TylerMiddendorf/bullet-time-cam/docs/evidence/README.md

# Evidence Index

Evidence is grouped by the milestone and checkpoint whose exit gate it supports.
Raw logs, screenshots, manifests, and summaries stay together so a result can be
reviewed without searching one large flat directory.

## Milestone 1 — Bench-Top End-to-End Capture

- [`checkpoint-1/`](milestone-1/checkpoint-1/) — Raspberry Pi, display, USB, and bench inventory
- [`checkpoint-4/`](milestone-1/checkpoint-4/) — one-node trigger-to-screen vertical slice, protocol fault/recovery tests, firmware deployment, electrical inspection, and four-node trigger integrity
- [`checkpoint-5/`](milestone-1/checkpoint-5/) — completed four-node product grouping, GIF/touchscreen flow, 25-cycle reliability, per-camera partial failures, corrupt/truncated recovery, reboot identity, byte validator, and UI photographs

## Milestone 2 — User-Removable USB Media

- [`removable-media-qualification-2026-07-18.md`](milestone-2/removable-media-qualification-2026-07-18.md)
  — complete real-Pi hardware matrix covering normal/reboot/reinsert/remount,
  missing/full/read-only/corrupt/mid-write loss, recovery, deterministic
  two-drive selection, and the physical-rig E2E test; it records the initial
  media-safety pass and the UI/filesystem findings discovered during that run
- [`focused-retest-and-fat-repair-2026-07-18.md`](milestone-2/focused-retest-and-fat-repair-2026-07-18.md)
  — app 0.2.1 fixes, automated tests, file-for-file product backup, FAT repair,
  stale-staging cleanup, focused real-UI removal/error retest, clean post-capture
  FAT check, and final byte-valid capture closing Milestone 2

- [`../MILESTONE_2_PLAN.md`](../MILESTONE_2_PLAN.md) — completed fault procedures,
  safety boundaries, evidence requirements, and exit gates
- [`milestone-2/`](milestone-2/) — USB-media discovery, mount bring-up, and
  qualifying fault/recovery evidence

## Qt Touchscreen Platform Track

- [`qt-ui-deployment-2026-07-18.md`](qt-touchscreen/qt-ui-deployment-2026-07-18.md)
  - tracked deployment chain, power-cycle recovery, native-Wayland validation,
  bounded real capture, product-media library performance, and final hardware
  state
- [`2026-07-18-pi-routes/`](qt-touchscreen/2026-07-18-pi-routes/) - seven final
  800x480 Pi route screenshots and their SHA-256 evidence manifest
- [`library-deletion-2026-07-19.md`](qt-touchscreen/library-deletion-2026-07-19.md)
  - confirmed whole-set deletion, native renders, and a disposable real-USB
  operation that preserved every pre-existing capture directory
- [`storage-capacity-2026-07-19.md`](qt-touchscreen/storage-capacity-2026-07-19.md)
  - app 0.2.4 used/available USB capacity metric, post-deployment asynchronous
  refresh regression and fix, exact real-capture/volume check, corrected native
  800x480 render, and final Pi runtime state
- [`navigation-reorganization-2026-07-19.md`](qt-touchscreen/navigation-reorganization-2026-07-19.md)
  - app 0.2.5 Ready/Settings/Library/Capture navigation, Capture-only
  touchscreen command boundary, commit/push/Pi-pull chain, final Pi tests,
  native-Wayland renders, actual live status screen, and the disconnected-node
  limitation
- [`navigation-icon-sizing-2026-07-19.md`](qt-touchscreen/navigation-icon-sizing-2026-07-19.md)
  - app 0.2.6 large Ready gear and Library home icon, native Pi render and
  interaction checks, commit/push/Pi-pull chain, and restarted-service health

## Milestone 5 — Fast Follow

- [`live-preview-2026-07-19.md`](milestone-5/live-preview-2026-07-19.md) —
  firmware/app 0.3.0, four-node memory-only preview, native 800x480 runtime,
  preview-active capture and comparison timing, USB recovery, post-recovery
  preview/capture, screenshots, manifests, and final boot/service state

Each new evidence directory should include or link to the relevant plan, state
the date and tested revision, distinguish successful gates from limitations,
and retain concrete artifacts where practical.
