TylerMiddendorf/bullet-time-cam/assets/ui/README.md

# Touchscreen UI Assets

`preview-placeholder.png` is generated test media for the Qt touchscreen
implementation. It provides a stable background for layout, focus-overlay, and
touch testing without implementing or implying a live camera stream.

The placeholder was generated on July 18, 2026 with the built-in image
generation tool using `assets/Logo_800x480.png` as its visual reference. Prompt
summary: a dark, wide camera-viewfinder background preserving the logo's black,
white, silver, and blue identity, with restrained optical rings and four-camera
geometry. It contains no embedded UI, text, watermark, battery indicator, or
claim that a live stream exists.

The runtime may scale or crop this image to the 800x480 display. Replace it only
when real preview transport becomes an explicitly approved milestone.
