TylerMiddendorf/bullet-time-cam/docs/CURRENT_SESSION.md

# Current Session - Fast-Follow Software

Status reviewed: July 19, 2026

## Qt UX Implementation Rollback Baseline

- Work on the Qt Quick/PySide6 interface began from Git commit `63420c1`
  (`Accept external V1 power arrangement`) on branch `main`.
- No files were staged when the implementation session began. An existing
  unstaged product-owner edit to `docs/MILESTONE_4_PLAN.md` was deliberately
  left untouched and is not part of the UI rollback baseline.
- To return to the exact pre-UI repository state without discarding unrelated
  working-tree changes, restore the UI commits relative to `63420c1`; do not
  use a destructive working-tree reset.
- Scope guard: implement the supplied UX mockups with a generated temporary
  preview image, but do not implement a live camera stream and do not display
  battery level or battery status.
- The completed Qt runtime is `fb1d1e7`. Pre-UI commit `63420c1`, the installer
  backup, and retained Tk packages provide a documented non-destructive recovery
  path, but an end-to-end rollback drill has not been performed.

## Verified State

- Milestones 1 and 2 are complete. The full four-camera workflow and removable
  USB fault/recovery behavior are physically validated.
- App 0.2.1 survives disappearance of its reviewed GIF, fits bounded errors on
  the 800x480 display, and cleans expired staging safely.
- The product FAT was backed up, repaired, and returned a clean offline check
  after final actual-UI capture `20260718T175104Z_04b69c0b`.
- The product owner accepted an external battery pack as the V1 power solution.
  It supplies separate rated 5 V / 2 A feeds to the Raspberry Pi and powered
  USB hub and has its own battery-percentage display.
- Aggregate measurement, internal battery/charging integration, and automatic
  safe-power sequencing are retired as V1 gates. No electrical measurement or
  coordinated shutdown evidence is claimed.
- The complete removable-media follow-up is in
  [`evidence/milestone-2/focused-retest-and-fat-repair-2026-07-18.md`](evidence/milestone-2/focused-retest-and-fat-repair-2026-07-18.md).
- Native Qt Quick/PySide6 now runs on the Pi's 800x480 Wayland session. Seven
  routes, a bounded real four-camera capture, and the 214-entry USB
  library passed SSH-accessible validation. Preview remains a labeled static
  logo fixture and the UI contains no battery state. Evidence is in
  [`evidence/qt-touchscreen/qt-ui-deployment-2026-07-18.md`](evidence/qt-touchscreen/qt-ui-deployment-2026-07-18.md).
- Confirmed deletion from the library and viewer is deployed at `3f99e76`.
  Pi tests, corrected native viewer/confirmation renders, and a disposable
  four-JPEG/GIF/manifest set on the real product USB passed while retaining all
  222 pre-existing capture directories. Evidence is in
  [`evidence/qt-touchscreen/library-deletion-2026-07-19.md`](evidence/qt-touchscreen/library-deletion-2026-07-19.md).
- The first Qt soft reboot failed to return to the LAN and required a physical
  power cycle. Recovery checks passed, but no persistent journal was available;
  the cause and clean Qt soft-reboot lifecycle remain open.
- App 0.2.5 reorganizes Ready into status plus gear/Settings, Library, and
  Capture navigation. Capture is the only touchscreen photo-taking route; its
  surface remains a truthfully labeled static placeholder pending live preview.
  Final commit `1d880c1` is deployed on the Pi and passed the final suite,
  native-Wayland renders, boot verifier, and live-screen inspection. The camera
  nodes were not enumerated, so no new physical capture was made in this pass.
- App 0.2.6 is deployed at `4be243c`. Ready's Settings gear and Library's home
  icon now fill most of their touch buttons. The final Pi suite, native route
  renders, Library-to-Ready interaction smoke, boot verifier, and restarted
  live service passed. Evidence is in
  [`evidence/qt-touchscreen/navigation-icon-sizing-2026-07-19.md`](evidence/qt-touchscreen/navigation-icon-sizing-2026-07-19.md).
- App 0.2.7 camera USB recovery is deployed at `83cfda4`. The Settings action
  passed native 800x480 rendering, the exact guarded root one-shot, four usable
  stable camera sessions, byte-valid capture `20260719T200154Z_65b3fe04`, the
  126-test Pi run with one expected skip, and all 39 boot checks. The product
  FAT was backed up, repaired, and verified clean offline; the retained backup
  is `/home/username/usb-recovery-backups/20260719T1605-camera-recovery`.
  Evidence is in
  [`evidence/qt-touchscreen/camera-usb-recovery-2026-07-19.md`](evidence/qt-touchscreen/camera-usb-recovery-2026-07-19.md).
- App 0.2.8 is deployed at `2153c7a`. Ready shows real removable-USB connected
  state, a circular used-capacity gauge, and available capacity; Settings has a
  large direct-to-Ready home icon matching Library. The 127-test Pi run with
  one expected skip, native renders, real product-volume read, interaction
  smoke, all 39 boot checks, and restarted live service passed. Evidence is in
  [`evidence/qt-touchscreen/ready-usb-storage-and-settings-home-2026-07-19.md`](evidence/qt-touchscreen/ready-usb-storage-and-settings-home-2026-07-19.md).
- App 0.2.9 is deployed at `ea9e4c5`. New usable captures atomically include a
  compact manifest-recorded JPEG library preview; catalog refresh reads it
  without opening the animation. Real four-camera capture
  `20260719T224502Z_b091c2b9` validated the preview and the live service was
  restored with all 39 boot/session checks passing. Evidence is in
  [`evidence/qt-touchscreen/library-capture-previews-2026-07-19.md`](evidence/qt-touchscreen/library-capture-previews-2026-07-19.md).
- App and firmware 0.3.0 are deployed through `ab8c357`. All four stable nodes
  serve bounded 320x240 memory-only previews; the native Capture route displays
  genuine rotating frames and stops preview before capture. Preview-active and
  comparison captures completed in 3.721 and 3.691 seconds respectively. The
  installed xHCI recovery, post-recovery preview and capture
  `20260720T005232Z_54ad4ce8`, 137 source tests, native 800x480 QML, all 39 boot
  checks, normal service, and GPIO17 LOW passed. Evidence is in
  [`evidence/milestone-5/live-preview-2026-07-19.md`](evidence/milestone-5/live-preview-2026-07-19.md).

## Immediate Work

Milestone 4 is deferred as active repository work while the product owner builds
the full enclosed prototype asynchronously. Its plan and acceptance gates remain
open and must be completed before the enclosure milestone is closed.

Continue with Milestone 5 software work:

1. Improve ordinary user-facing status and recovery behavior where demonstrated
   gaps exist.
2. Continue investigating the soft two-second latency target and unexplained Qt
   soft-reboot failure as bounded software reliability work.
