TylerMiddendorf/bullet-time-cam/docs/PROJECT_CONTEXT.md

# Bullet-Time Camera Rig - Project Context

This file is the durable project brief. Update it as product decisions are made so future work can begin from the actual system goal rather than treating the ESP32 camera-node firmware as the entire project.

## Product Goal

Build a production-like, complete bullet-time camera rig that is handheld and fairly compact. The first complete product uses four cameras. The longer-term ideal is an architecture that can scale to 12 or more cameras.

The finished device is intended to:

1. Initially use four cameras positioned to capture the subject from four viewpoints.
2. Give each camera its own Seeed Studio XIAO ESP32S3 Sense computer.
3. Use a central computer to coordinate capture, collect all four images, clean up and improve image quality, and turn the result into an animated GIF that moves through the viewpoints.
4. Provide an integrated screen where the user can adjust camera settings, review captured images, and potentially see previews before capture.
5. Provide a physical shutter button that behaves like the button on a normal camera.
6. Run from the selected external battery pack, using separate rated 5 V / 2 A
   feeds for the Raspberry Pi and powered USB hub.
7. Provide a removable USB drive so the user can take completed images and animations off the camera while the Raspberry Pi boot microSD remains protected inside the device.
8. Potentially host a Wi-Fi hotspot from the central computer so a phone or laptop can browse and retrieve finished media.

The likely central computer is a Raspberry Pi 4 Model B, but that selection is provisional.

## Intended User Experience

The current product concept is:

1. Power the enclosed handheld camera from its selected external battery pack.
2. See no operating-system content during boot: the display may remain blank during the early kernel phase, then shows only the product logo followed directly by the full-screen camera application, without boot logs, cursors, or loading diagnostics.
3. Use its screen to review status and configure capture settings.
4. Hold and aim the rig like a normal digital camera.
5. Press one physical shutter button.
6. All four camera nodes capture their viewpoints.
7. The central computer receives the images and performs the post-processing pipeline.
8. The initial product plays the four photographs in sequence and then reverses direction, creating the appearance of a camera moving back and forth while time is frozen.
9. Under normal conditions, a reviewable result targets appearing on the built-in screen within two seconds after capture.
10. The user retrieves finished media from removable storage and, potentially, through the device's Wi-Fi hotspot.

The intended subjects include people, places, and objects. The expected capture environment has good light, such as daylight outdoors or an LED ring illuminating the scene.

Details of the later live-preview experience and the retake flow remain to be decided.

The completed version 1 base used this deliberately simpler screen scope; the
Milestone 5 fast follow has since added live preview:

- No live preview before capture in the completed V1 base; superseded by the
  validated Milestone 5 rotating preview
- No user-adjustable camera settings
- A removable-USB library for browsing, viewing, and deleting complete capture sets
- A capture/loading screen while a shot is being acquired and assembled
- Post-capture review of the generated animation
- The most recent animation remains displayed until the next capture begins
- Basic system and capture status as needed

Live preview is the first planned follow-up after version 1 end-to-end integration. User-adjustable camera settings are deferred to version 2.

## Capture Geometry and Output

### Initial product

- The four cameras are arranged side by side in one horizontal line.
- Adjacent camera sensors are spaced approximately 4 cm apart.
- Four cameras therefore have an approximate 12 cm first-to-last sensor span, before enclosure margins.
- All four cameras point straight ahead.
- All four capture at approximately the same moment.
- The four viewpoints are played as a back-and-forth animation.
- The visual effect should resemble one camera moving horizontally while the subject and scene remain frozen in time.
- The first implementation uses the four captured images directly.
- Version 1 performs no alignment, color matching, exposure normalization, or AI interpolation.
- Version 1 preserves all four original JPEGs and the generated animated GIF.
- The device has a soft two-second shutter-to-review target under normal conditions.
- A typical subject distance is about 3.5 ft (approximately 1.07 m), although the camera should remain usable at longer and other practical distances.

Total enclosure width and animation timing remain open.

### Scaled camera array

- The ideal later system has 12 or more cameras.
- The approximately 4 cm sensor pitch is the current geometry target.
- A 12-camera array at that pitch spans about 44 cm from the first sensor to the last, before enclosure margins.
- At four cameras the sensors are close enough to point straight ahead.
- A larger array will need a slight curve so its outer cameras converge toward the useful subject region.
- The camera-node and central-control architecture should avoid unnecessary assumptions that permanently limit the system to four nodes.

### Future processing

Later versions may:

- Align the four views.
- Correct differences so the views look as though they came from one consistently configured camera.
- Use AI frame interpolation to create a smoother apparent camera move.
- Explore NeRF or 3D Gaussian Splatting for richer novel-view or 3D results.

These are future enhancements rather than requirements for the first complete four-frame product.

The quality-processing work begins after the complete device can reliably capture, transfer, animate, display, and preserve a four-image set end to end.

## System Architecture

### Camera nodes - confirmed hardware

There are four identical camera nodes. Each currently consists of:

- Seeed Studio XIAO ESP32S3 Sense
- OV3660 camera sensor
- Connection to the shared physical trigger
- The same Arduino camera-node firmware

Firmware 0.3.0 retains the July 17 simplified node design and adds bounded
BTC1 preview requests/images. Nodes remain at 320x240 JPEG while idle, switch
to 2048x1536 only after the shared trigger, use the qualified settle/warmup
sequence, restore preview mode before transfer, and never access node storage.
The same image is flashed to all four nodes and passes camera, BTC1 stable-
identity, shared-trigger, genuine-preview, full-resolution capture, and recovery
gates. `D0 / GPIO1` remains unused.

### Central computer - validated V1 bench implementation

The version 1 bench system uses the available Raspberry Pi 4 Model B with 2 GB
RAM and Raspberry Pi OS. The implemented application:

- Coordinates the four-node capture workflow
- Acquires concurrent CRC-checked JPEG streams from all four ESP32S3 nodes
- Groups node transactions into complete or camera-specific partial capture sets
- Creates the ordered back-and-forth animated GIF
- Atomically preserves every successful original, manifest, and GIF
- Drives the full-screen loading, review, and error interface
- Selects and manages removable USB media without falling back to the boot card
- Records capture, transfer, processing, storage, and resource measurements

Image alignment, appearance normalization, other quality-improvement processing,
and network media access remain future work. The Pi remains the V1 central-
computer candidate through enclosure integration and the unresolved latency
tradeoff. Its current operating system and USB communication path are fixed as
the validated version 1 bench baseline. The measured four-node median is 3.250
seconds, above the soft two-second target.

### Camera-node communication - USB selected for V1

The two transport candidates evaluated for the product were USB and Wi-Fi.

USB advantages:

- Lower and more predictable latency
- Lower radio energy use
- Less software and network complexity
- Better behavior in radio-dense environments such as music festivals

USB disadvantages:

- More internal wiring and connectors
- Requires sufficient central USB ports or an internal USB hub
- Becomes increasingly cumbersome when scaling from four to 12 or more nodes

Wi-Fi advantages:

- Less physical data wiring
- Potentially lower assembly cost
- Easier physical scaling to more camera nodes

Wi-Fi disadvantages:

- Greater susceptibility to congestion and interference
- Higher energy use
- More discovery, connection, retry, and failure-handling complexity
- Less deterministic multi-node transfer timing

USB is the selected version 1 transport. The final installed hub/cabling chain
has passed concurrent four-node integrity, grouping, persistence, animation, and
review tests. The Pi application keeps protocol, capture coordination, storage,
and UI concerns separated so a future transport does not require rewriting the
complete workflow. Wi-Fi is deferred unless USB exposes a concrete blocker and
may be reconsidered for a 12+ node array.

### Trigger architecture

For the first complete version, the physical shutter button pulls the shared active-low `D1 / GPIO2` trigger line used by all camera nodes. All four camera grounds share the trigger reference.

The Raspberry Pi also initiates the same simultaneous hardware capture through BCM `GPIO17` (physical pin 11) and a 2N3904 NPN open-collector stage. GPIO17 connects through 4.7 kOhm to the transistor base; a 100 kOhm resistor pulls the base to common ground; the emitter connects to common ground; and the collector connects to the shared trigger bus. GPIO17 idles low and pulses high for 100 ms, causing the transistor to pull the trigger bus low without ever driving the bus high. The Pi learns that capture began from the nodes' USB `CAPTURE_STARTED` messages rather than a separate trigger-sense GPIO. The complete circuit, power-sequencing rules, and validation sequence are in [`TRIGGER_CIRCUIT.md`](TRIGGER_CIRCUIT.md).

### Display and controls

The touchscreen application uses Qt Quick/QML with a PySide6 bridge on the
Raspberry Pi. Its seven native 800x480 routes cover Ready, capture progress,
camera-specific partial review, Capture, Settings, Library, and a detached GIF
viewer. Runtime QML implements the layouts directly; it does not display the
mockup screenshots.

Ready is a status-and-navigation screen. It retains USB state, all four camera
statuses, and the READY/ATTENTION detail while offering a gear icon for
Settings, Library, and Capture. It cannot enqueue a touchscreen capture.
Ready also reports whether removable USB storage is connected and shows a
circular used-capacity gauge plus available space from that selected USB
filesystem. It never substitutes boot-card capacity.
Capture is the only touchscreen route that can take a photo; Review and
Settings link to it instead of emitting capture commands. App 0.3.0 displays
genuine 320x240 JPEG previews polled one at a time across logical Cameras 1-4.
The newest validated frame remains in memory only and is attributed by camera
number. Preview stops before capture and whenever the user leaves Capture;
there is no Qt Multimedia dependency. The independent physical shutter
continues to use the shared hardware trigger. Camera settings are visible only
as disabled future controls and emit no node commands. Settings also provides
an idle-only `RECONNECT CAMERAS` system-recovery action. Its narrowly privileged
root helper cleanly unmounts USB filesystems, resets the validated Pi xHCI
controller, waits for four usable ESP32 serial ports, and restarts the UI; it
does not alter node configuration. The Library validates published schema-2
capture sets and reads compact JPEG previews generated atomically when each new
capture is published. Historical sets without previews retain a bounded
first-frame GIF fallback. Selected GIFs are still decoded away from removable
media before viewer display. A confirmed
delete action is available from the library and viewer; it revalidates the
selected set and removes that set's originals, GIF, and manifest together from
removable USB storage. Its route back to Ready uses a large home icon rather
than a text label, matching the large gear icon used for Settings on Ready.
The Settings route also has the same large home icon for a direct return to
Ready. The library retains touch flicking and provides right-side page-up and
page-down controls with a current/total page indicator for discoverable
navigation through large catalogs. Its sidebar reports used and available
capacity from the selected removable USB filesystem; it does not substitute
boot-card capacity when USB media is unavailable. The application contains no battery state, battery display, or
reserved battery region, and it makes no hotspot or network-connectivity claim.

The installed display is an 800x480 HDMI touchscreen. A July 17 query of the running Pi reports HDMI-A-2 at 65.681 Hz with a 150x100 mm physical area and generic EDID identity `Addi-Data GmbH`, model `0x0004`, serial `0x00000001`. Touch is provided by USB controller `8888:6666` over the display's micro-USB connection. That interface advertises USB 5 V / 100 mA maximum (0.5 W); this is descriptor data, not a measurement of the entire panel and backlight. Outer bezel/depth and actual load require physical measurement if needed for enclosure or battery sizing.

Planned capability sequence:

1. Version 1: status-only Ready navigation, a dedicated Capture route,
   capture/loading state, persistent latest-result review, and removable-media
   Library browsing/deletion
2. Fast follow: live preview
3. Version 2: user-adjustable camera settings
4. Much later: network-based media access, remote control, and other Wi-Fi features after the onboard experience is polished

Provisional visual explorations for these phases are indexed under
[`../designs/ux-mockups/`](../designs/ux-mockups/README.md). Seven selected
compositions have now been translated into and rendered as native QML on the
physical Pi display. The mockups remain design references rather than runtime
assets; operative settings remain later work.

### Power - selected version 1 arrangement

On July 18, 2026, the product owner selected an external battery pack as the
complete V1 power solution. The pack provides two separate rated outputs:

- 5 V / 2 A to the Raspberry Pi
- 5 V / 2 A to the powered USB hub

The pack has its own battery-percentage display. The product owner considers
power handled and retired further aggregate-power measurement, internal-battery
integration, fuel-gauge, charging, and automatic power-cut work as V1 gates.
This supersedes the earlier internal rechargeable battery and coordinated
low-battery shutdown direction for V1.

No repository evidence independently measures total current, output regulation,
runtime, or shutdown behavior. Those are not claimed as demonstrated and are no
longer remaining V1 acceptance gates unless the product owner reopens them.

### Storage - prototype and planned

Historical prototype storage:

- Each camera node saved captures to its own 16 GB card before firmware 0.2.0 superseded that path.

Approved camera-node revision:

- Remove node microSD initialization, saving, backup, diagnostics, and card requirements from the firmware and deployment checks.
- Transfer every live JPEG directly from the ESP32S3 frame buffer to the central computer.
- Preserve user media centrally; removing node cards does not remove the separate user-removable media requirement.

Current central storage design:

- A user-removable USB mass-storage drive for finished captures and animations
- Direct BTC1/USB image transfer from each node's frame buffer to the central computer
- A protected internal microSD card dedicated to the Raspberry Pi operating system and application
- Automatic Raspberry Pi application discovery of writable USB-backed filesystems
- A `BulletTime/` directory on the selected USB drive containing capture-set directories, original JPEGs, manifests, and generated GIFs

Firmware 0.3.0 transmits the captured JPEG directly from the ESP32S3 frame
buffer and returns the buffer after the ACK/NACK transfer attempt. Preview
frames remain memory-only and do not enter this storage path. Simultaneous
four-node operation is validated at product level. The qualifying pre-preview
25-cycle run completed every set, but its 3.250-second median remains above the
soft two-second target; the preview-active/same-firmware comparison was
3.721/3.691 seconds for the current larger-image scene.

The Raspberry Pi boot card should not be normally accessible to the user. The removable USB drive uses a user-accessible USB port. The application must not fall back to the boot card when USB media is absent: touchscreen-initiated capture is blocked before a Pi trigger, and a physical/shared-bus capture that arrives without writable USB storage is rejected rather than committed internally. Raspberry Pi hardware tests cover missing, full, read-only, corrupt/unmountable, and active-write removal plus deterministic multi-drive selection. Their media-safety behavior passed; app 0.2.1 also keeps Tk polling alive when reviewed media disappears, fits storage errors within 800x480, and cleans unmistakably stale capture staging after a guarded age threshold.

### Enclosure and physical design

Version 1 uses a simple 3D-printed box-shaped enclosure. It should:

- Be kept reasonably compact
- Protect and contain the complete integrated system
- Provide openings for all components that need external access
- Hold the four cameras in the defined straight horizontal arrangement

Version 1 does not have numerical weight or ergonomic targets. Integrated lighting, a tripod mount, weather resistance, refined grip geometry, and a polished industrial design are deferred to later revisions.

Exact dimensions should be set after the central computer, display, USB or network hardware, removable USB-drive access, power electronics, battery, cooling, and internal wiring are selected and arranged.

### Failure behavior

Version 1 uses graceful degradation for capture and transfer failures:

- A failure by one camera does not discard successful images from the other cameras.
- The central computer continues saving and processing the images that arrived successfully.
- It creates the best available result from the remaining images when possible.
- The screen clearly reports that an error occurred.
- The error identifies the logical camera number and shows relevant diagnostic details.
- A stable camera identity scheme is therefore required even though all nodes run the same firmware.

The two-second shutter-to-review goal is a soft normal-case target. It may be exceeded while a capture, transfer, save, or other operation is actively progressing, and the loading screen remains active rather than reporting a false timeout. The runtime now uses bounded association and no-progress windows, preserves usable partial sets, and creates an animation when at least two views succeed. Broader user-facing retry policy and removable-media fault recovery are refined through later milestones.

## Current State

As of July 19, 2026:

- Four XIAO ESP32S3 Sense modules and four OV3660 sensors are on hand. Four node cards from the superseded prototype remain in inventory but are not used by current firmware.
- All four modules are assembled on a breadboard.
- A universal/shared shutter button is wired to all four nodes.
- Historical/superseded: each node previously used an individual status LED.
- The selected external battery pack powers the Raspberry Pi from one rated
  5 V / 2 A output and the powered USB hub from a separate rated 5 V / 2 A
  output; the pack provides its own battery-percentage display.
- The shared button and all four camera nodes work as expected.
- Historical/superseded: the original prototype saved images to individual node cards.
- Firmware 0.3.0 is flashed and startup-verified on all four nodes. It leaves
  `D0 / GPIO1` unused, serves bounded memory-only preview JPEGs, and transfers
  full-resolution captures directly through BTC1 without node storage.
- A Raspberry Pi 4 Model B with 2 GB RAM is on hand.
- The Raspberry Pi 4 has been imaged and boots Raspberry Pi OS successfully with the intended 800x480 HDMI display.
- Touch input works on the intended display.
- The display uses HDMI video and a micro-USB connection for touch and/or display-side power.
- The Raspberry Pi is reachable on the bench LAN as `camerapi` at the current address `10.0.0.136`, with OpenSSH enabled and verified key-based login for the local Windows/Codex development account.
- The dedicated private SSH key is stored outside the repository under the Windows user profile; non-secret connection details, the pinned host-key fingerprint, access boundaries, and recovery guidance are recorded in `docs/RASPBERRY_PI_SSH.md`.
- The final V1 USB hub/cabling chain is installed on the Raspberry Pi. The Pi reports VIA Labs `2109:3431` feeding Terminus `1a40:0101`; the four ESP32 nodes enumerate concurrently through the downstream four-port hub at 12 Mb/s, while the touchscreen and removable drive also enumerate on the installed chain.
- A 3D printer is available.
- The final integrated USB hub/cabling selection is installed and has passed the recorded four-node concurrent integrity runs. Aggregate system power remains unmeasured but is no longer a V1 gate by product-owner decision.
- The external two-output battery pack is the accepted V1 power arrangement; no internal battery/charging integration is planned for V1.
- The product owner has added a USB drive to the Raspberry Pi for removable JPEG/GIF storage.
- The Pi application detects mounted USB-backed filesystems, can request automatic mounting through `udisks2`, writes capture sets below `BulletTime/`, records the selected USB filesystem in each manifest, and refuses to fall back to the boot microSD. The product drive is identified by USB serial `900049666ACEB315`, UUID `B67C-53C4`, and label/mount name `USB DISK`; its `/dev/sdX` letter may change after re-enumeration. Product-level four-original/manifest/GIF persistence and reboot continuity pass on this drive.
- The July 18 Milestone 2 hardware session exercised physical idle reinsertion, automatic remount, missing/full/read-only/corrupt media, deterministic removal during active staging, recovery, and preferred/fallback/no-preference two-drive selection without creating boot-card media or valid-looking failed sets. All restored states reached a byte-valid four-camera capture. At that first handoff, the product drive had a pre-existing FAT dirty bit and clearly uncommitted July 17 staging directory; storage-error screens clipped long text, and removal of the currently reviewed GIF killed the Tk poll callback until service restart. Evidence is in `docs/evidence/milestone-2/removable-media-qualification-2026-07-18.md`.
- Raspberry Pi/display bring-up, concurrent four-node grouping, multi-image GIF generation, camera-specific partial capture, touchscreen review, and normal removable-USB persistence are implemented and physically validated. Enclosure work remains.
- Approximately $200 remains available for version 1.
- The physical button and Pi GPIO17/2N3904 stage are connected to the four-node shared trigger. The framed Pi-to-node USB request remains explicit diagnostic scaffolding only; normal touchscreen actions use one 100 ms GPIO17 pulse.
- The Git-tracked Pi application and camera firmware complete the physical/Pi-trigger-to-touchscreen path through all four powered nodes, with CRC validation, atomic capture-set preservation, ordered GIFs, manifests, resource/timing instrumentation, camera-specific partial review, and reconnect discovery by stable node UID.
- A final 20-capture resource-instrumented run completed 20/20 captures with no checksum failures, recorded errors, or partial files. Median capture-event-to-display callback was 2.494 seconds, so the soft two-second target is not yet met; camera acquisition (1.374 seconds median) and node transfer (0.773 seconds median) dominate.
- A forced receiver interruption left no committed or partial capture, and the app/node recovered without a Pi reboot. Two literal cable unplug/replug cycles preserved logical Camera 1 and service continuity; a live disconnect displayed a missing-node error and recovered visibly. A deliberately corrupted live USB payload produced a targeted NACK and visible checksum error without committing an original or partial file; the next normal capture succeeded.
- On July 17, one physical press and one normal Pi touchscreen action each produced exactly one Camera 1 capture through atomic commit and display with no error. Separate four-node observers showed one physical press and one real 100 ms GPIO17 pulse each produced exactly one valid capture per stable UID with zero duplicates/errors. A 10-cycle GPIO17 run passed all 40 captures; pulse-to-all-completions was 2.455 seconds median and 2.497 seconds maximum, with 4.930 ms maximum start spread.
- Later on July 17, the repository/module reorganization at `b950740` was pushed before the Pi pulled it, then regression-tested on the physical rig. The exact rebuilt firmware passed all three startup gates on all four reflashed nodes; another 10-cycle GPIO17 run passed 40/40 valid captures with zero duplicates/errors. The renamed `bullet-time-ui.service`, removable USB capture, and all 33 automated boot checks passed both installation and a requested Pi reboot; a post-reboot real capture was CRC-valid and the service returned active with GPIO17 LOW. Detailed evidence is in `docs/evidence/milestone-1/checkpoint-4/refactor-hardware-regression-2026-07-17.md`.
- On July 18, the full product coordinator passed its physical-rig E2E contract: 25/25 complete four-node sets (100 originals and 25 six-frame GIFs), every logical camera unavailable separately, checksum-corrupt and mid-transfer-truncated Camera 1 cases with complete recovery, stable Camera 4 identity through reboot, and separate physical-shutter and touchscreen/GPIO17 product captures. The byte validator passed 35 named sets and the environment-gated live suite passed. Complete-set time was 3.250 seconds median and 3.289 seconds maximum, so the soft two-second target remains open. Representative normal and corrected camera-specific partial screens were photographed. See `docs/evidence/milestone-1/checkpoint-5/checkpoint5-four-node-e2e-2026-07-18.md`.
- Later on July 18, the complete removable-media hardware matrix passed fail-closed, atomic-publication, no-boot-card-fallback, recovery, and deterministic two-drive selection checks. Missing, full, read-only, corrupt/unmountable, and deterministic mid-write USB-storage removal were exercised on the Pi; every restored state completed a byte-valid four-camera capture, and the environment-gated four-node E2E test passed with its ledger. Qualification also exposed a Tk poll-callback crash when reviewed media disappears, clipped storage-error text, a dirty product FAT, and one pre-existing stale staging directory. See `docs/evidence/milestone-2/removable-media-qualification-2026-07-18.md`.
- The focused July 18 follow-up resolved those findings. App 0.2.1 survived the live removed-review exception without restarting, bounded storage and camera-disconnect text at 800x480, and removed the expired staging directory through guarded cleanup. A complete 1,224-file/947,483,006-byte product-media backup matched every source SHA-256 before `fsck.vfat` repaired the dirty FAT and reconciled the boot-sector difference. The offline check passed both immediately and after final actual-UI four-camera capture `20260718T175104Z_04b69c0b`; that set passed byte and GIF-order validation. See `docs/evidence/milestone-2/focused-retest-and-fat-repair-2026-07-18.md`.
- The first Milestone 3 inventory found no Pi `power_supply` entries, no `hwmon` voltage/current/power inputs, and no USB device identifiable as an electrical power meter. `get_throttled=0x0` is a health flag rather than an aggregate measurement. The product owner subsequently retired that measurement work and accepted the external two-output battery pack as the V1 power solution; see `docs/MILESTONE_3_PLAN.md`.
- On July 18, the native Qt Quick/PySide6 touchscreen track was deployed and
  validated on the physical Raspberry Pi through the required commit, push,
  fast-forward pull workflow. Commit `fb1d1e7` runs natively on Wayland without
  Xwayland and the deterministic Pi suite passed 112 tests with one expected
  live evidence skip. Seven route renders produced across `d502fff` and
  `828831b` are preserved at 800x480 with exact per-route attribution and zero
  QML warnings; the later `fb1d1e7` library change was validated separately on
  real media. One bounded real-UI capture produced complete set
  `20260719T021211Z_4be2d832`; the service returned active with GPIO17 LOW. The
  real 214-entry product-media catalog validates every entry while eagerly
  decoding only the first six thumbnails, reducing initial load from 21.101
  seconds to 0.527 seconds. See
  `docs/evidence/qt-touchscreen/qt-ui-deployment-2026-07-18.md`.
- Three July 18 touchscreen follow-ups were each committed, pushed,
  fast-forward pulled, and natively rendered on the Pi. They bound the ready
  capture prompt, bound the removable-USB heading, and added working right-side
  six-item pagination controls. UI code commit `ce5871f` passed the Qt tests,
  seven-route contract, native 800x480 Wayland render, and an on-Pi page-change
  interaction smoke with correct first/last-page button states.
- On July 19, confirmed whole-capture-set deletion was deployed on the Pi at
  `3f99e76`. The final Pi suite passed 117/118 tests with only the expected live
  evidence skip; production QML and native 800x480 viewer/confirmation renders
  passed without QML errors. A disposable real-USB set containing four JPEGs,
  one GIF, and one manifest was deleted, the valid catalog returned from 220 to
  219 entries, and all 222 pre-existing capture directories remained unchanged.
  See `docs/evidence/qt-touchscreen/library-deletion-2026-07-19.md`.
- Later on July 19, app 0.2.4 added used and available capacity from the active
  removable USB filesystem to the library sidebar. Initial backend and layout
  checks missed an asynchronous result-handoff defect that left the real
  library stuck refreshing. A product-owner capture exposed the failure;
  commit `00d7531` corrected the shared result queue and added regression
  coverage. The Pi suite passed 121/122 tests with only the expected live-
  evidence skip, and the corrected path returned the valid new capture plus
  `3.8 MB` used / `248.0 GB` available from `/dev/sdb1`. See
  `docs/evidence/qt-touchscreen/storage-capacity-2026-07-19.md`.
- App 0.2.5 reorganizes Ready into status plus gear/Settings, Library, and
  Capture navigation. Capture is the only touchscreen route that can enqueue a
  photo. Final commit `1d880c1` passed 124 Pi tests (one expected live-evidence
  skip), native Wayland route rendering, the boot/session verifier, and a live
  service-screen inspection. The camera nodes were not enumerated during that
  UI pass, so no new four-camera capture is claimed. See
  `docs/evidence/qt-touchscreen/navigation-reorganization-2026-07-19.md`.
- App 0.2.6 replaces the Library screen's text return action with a large home
  icon and enlarges Ready's Settings gear. Final commit `4be243c` passed 124 Pi
  tests (one expected live-evidence skip), native Wayland renders, a
  Library-to-Ready QML interaction smoke, the boot/session verifier, and live
  service inspection. The camera nodes remained disconnected during this
  UI-only pass. See
  `docs/evidence/qt-touchscreen/navigation-icon-sizing-2026-07-19.md`.
- App 0.2.7 adds the idle-only Settings `RECONNECT CAMERAS` action after a live
  xHCI invalid-context/enumeration failure removed the complete downstream
  camera branch. Final commit `83cfda4` passed the guarded one-shot recovery,
  native 800x480 Settings render, four usable stable camera sessions, byte-valid
  post-recovery capture `20260719T200154Z_65b3fe04`, 125 deterministic Pi tests
  with one expected skip, all 39 boot checks, read/write removable storage, and
  GPIO17 output LOW. A full 20-file product-drive backup was retained before
  clearing a discovered FAT dirty bit; the separate offline no-write check and
  post-remount byte comparison passed. See
  `docs/evidence/qt-touchscreen/camera-usb-recovery-2026-07-19.md`.
- App 0.2.8 adds a USB-connected state and circular removable-storage usage
  gauge to Ready, plus a large Settings-to-Ready home button. Final code commit
  `2153c7a` passed 127 Pi tests with one expected skip, native 800x480 Ready and
  Settings renders, a Settings-to-Ready interaction smoke, real product-volume
  capacity resolution, all 39 boot checks, and live-service inspection. See
  `docs/evidence/qt-touchscreen/ready-usb-storage-and-settings-home-2026-07-19.md`.
- App 0.2.9 generates a compact `library_preview.jpg` inside every newly
  published usable capture set and records its size, checksum, and dimensions
  in the manifest. The library reads these previews directly instead of
  decoding GIFs during catalog refresh; legacy sets retain the six-visible-item
  GIF fallback. Real four-camera capture `20260719T224502Z_b091c2b9` published
  and validated a 1,602-byte 180x135 preview, and its four-entry product catalog
  scanned in 0.081 seconds. See
  `docs/evidence/qt-touchscreen/library-capture-previews-2026-07-19.md`.
- App 0.3.0 and firmware 0.3.0 implement genuine rotating four-camera preview.
  A storage-disabled smoke passed three 320x240 CRC-valid frames from every
  stable UID; the native runtime displayed the frames at 800x480 with zero QML
  errors. Preview-active capture `20260720T004727Z_c062657b` completed all four
  originals in 3.721 seconds versus 3.691 seconds for the same-firmware
  preview-disabled comparison. USB recovery, two new previews per camera,
  post-recovery capture `20260720T005232Z_54ad4ce8`, all 39 boot checks, the
  normal service, and GPIO17 LOW passed. See
  `docs/evidence/milestone-5/live-preview-2026-07-19.md`.
- The first Qt `sudo reboot` did not return to the LAN. A physical power cycle
  recovered the Pi, after which the verifier, service, cameras, GPIO, storage,
  and native Wayland session passed. Persistent journal data was unavailable,
  so the soft-reboot failure remains unexplained and the Qt soft-reboot
  lifecycle is not claimed as validated.
- The product owner initially connected the trigger circuit while powered, then later completed the full prescribed unpowered multimeter checklist and reported every continuity, resistance, button, isolation, and no-direct-short check passing. Individual readings were not retained.
- July 16-17 product-boot trials found four constraints on the current Raspberry Pi OS Trixie/kernel build. A custom Plymouth script theme crashed Plymouth 24.004.60 in `libply-splash-core`/`libply`; Raspberry Pi's initramfs early-fullscreen-logo path produced black/no-signal output and never reached networking; after the generated hook/package were removed and initramfs rebuilt, a console-less boot still failed to reach networking while the otherwise identical `console=tty1` recovery boot succeeded; and regenerating the already-clean initramfs after that successful boot again prevented the Pi from reaching userspace. The visually accepted implementation disables both splash mechanisms and desktop chrome, bypasses initramfs with `auto_initramfs=0`, retires Raspberry Pi Imager's completed NoCloud/cloud-init boot stages, retains one masked/silenced `tty1` console for boot compatibility, loads a transparent compositor cursor, and produces a blank early boot followed by matched compositor/application logo frames and the camera UI. The July 17 final cold boot showed no operating-system text or cursor and passed all automated checks. Reproduction and recovery are documented in `docs/RASPBERRY_PI_BOOT_RUNBOOK.md`.

The project now has a validated four-node Raspberry Pi product workflow for both trigger sources plus genuine rotating preview on the physical 800x480 display. The node-to-Pi protocol, direct concurrent JPEG transfer, integrity checks, atomic capture-set preservation, ordered GIF generation, instrumentation, camera-specific partial degradation, native Qt touchscreen review, and memory-only preview work on the physical rig. Raspberry Pi GPIO17 is deployed, idles output LOW, and has passed fake-backend plus powered hardware tests. Milestone 1 is complete, with the 3.250-second median review latency explicitly retained above the soft two-second target. Milestone 2 removable-media qualification is complete, including fault recovery, UI recovery/presentation, staging cleanup, and repaired product FAT. The Qt touchscreen platform track and Milestone 5 live-preview implementation are complete; operative camera settings remain planned for Milestone 6. The product owner accepted the external battery pack and closed Milestone 3 without aggregate measurement. The full enclosed prototype remains incomplete and is being built asynchronously by the product owner.

Milestone 4 enclosure work is deferred in the repository while the product owner builds the full enclosed prototype asynchronously. Milestone 5 remains active for ordinary status/recovery refinement, the unexplained Qt soft-reboot failure, and latency optimization; its live-preview checkpoint is complete. A synchronized settings/control milestone remains planned after Milestone 5; its inventory, UI structure, protocol boundaries, and qualification gates are in `MILESTONE_6_SETTINGS_AND_CONTROL_UI_PLAN.md`. See `ROADMAP.md`, `MILESTONE_5_PLAN.md`, `MILESTONE_4_PLAN.md`, the closed `MILESTONE_3_PLAN.md`, the completed `MILESTONE_2_PLAN.md`, the completed `MILESTONE_1_PLAN.md`, and `FOUR_NODE_E2E_TEST_PLAN.md`.

The project is milestone-driven and has no fixed completion date. Work advances when the current milestone's exit criteria are satisfied.

## Confirmed Decisions

- The first complete rig has four cameras.
- The longer-term ideal is 12 or more cameras.
- Adjacent sensors are spaced about 4 cm apart.
- The four-camera array points straight ahead; a larger array will require a slight curve.
- The typical subject distance is about 3.5 ft, with support for other distances.
- Each camera has its own ESP32S3 computer.
- The device has a central computer in addition to the camera nodes.
- The device is intended to be handheld and fairly compact.
- The primary output is an animated GIF that moves through the captured viewpoints.
- The initial animation uses the four captured photographs and plays back and forth.
- Version 1 uses the raw captured images without alignment or appearance normalization.
- Every original image and the generated GIF are preserved.
- The completed V1 base provided post-capture review without preview. The
  Milestone 5 fast follow now provides rotating four-camera preview. Ready is a
  status-and-navigation screen, and Capture is the only touchscreen route that
  can enqueue a photo.
- During capture, version 1 displays a loading/capture screen.
- After capture, the latest result remains displayed until the next capture.
- During boot, the display shows only `assets/Logo_800x480.png` and transitions directly to the full-screen camera application; Raspberry Pi firmware artwork, desktop UI, boot logs, cursors, and startup diagnostics are not user-visible.
- Version 1 provides a Library for browsing published capture sets, a detached GIF viewer,
  and confirmed deletion of a complete selected set. Deletion removes the set's
  original JPEGs, animation GIF, and manifest together from removable USB media;
  rename, editing, sharing, and boot-card browsing remain unsupported.
- Ready's Settings action and Library's Ready/Home action use large icon-only
  controls whose glyphs occupy most of their touch targets.
- Ready reports removable-USB connection and circular used capacity from the
  selected USB filesystem; Settings also provides a large direct-to-Ready home
  icon matching Library.
- Live preview is a fast-follow feature after end-to-end integration.
- User-adjustable camera settings are deferred to version 2.
- Version 2 settings are planned as a synchronized four-camera control system,
  not four unrelated camera panels. Ordinary controls apply to all nodes and
  require per-node acknowledgement/readback; individual adjustment is reserved
  for protected calibration and service workflows.
- The planned Settings hierarchy separates Camera, Capture & Animation,
  Cameras, Storage, Display & Controls, System, and About & Diagnostics.
  Unsupported future capabilities remain hidden until implemented and
  validated.
- The four cameras are mounted side by side in a horizontal line.
- The rig is held and aimed like a normal digital camera.
- Expected subjects include people, places, and objects.
- Captures assume good daylight or added lighting such as an LED ring.
- A reviewable result targets appearing within two seconds after capture under normal conditions.
- The two-second target is soft and may be exceeded while work is actively progressing.
- The first version continues to use the shared physical trigger line.
- The Raspberry Pi can activate the shared trigger through the validated GPIO17/2N3904 open-collector stage.
- Camera-node local storage and GPIO-driven status indication are removed from firmware 0.2.3; all four nodes pass revised startup and physical/Pi-trigger functional capture gates, and the product owner reported the full unpowered circuit checklist passing.
- Live JPEGs transfer directly from each ESP32S3 frame buffer to the central computer.
- Each node uses `D1 / GPIO2` for the shared active-low physical trigger; `D0 / GPIO1` is unused.
- Raspberry Pi BCM GPIO17, physical pin 11, activates the shared trigger through the documented 2N3904 open-collector circuit.
- The Pi observes capture start through USB `CAPTURE_STARTED` messages rather than a separate trigger-sense GPIO.
- The final device has an integrated screen and a physical shutter button.
- Version 1 uses an external battery pack with separate rated 5 V / 2 A outputs
  for the Raspberry Pi and powered USB hub.
- The selected pack's own battery-percentage display is the V1 charge indicator.
- The user needs removable USB storage for exported media.
- Raspberry Pi boot storage is a protected internal microSD card.
- Original JPEGs, manifests, and generated GIFs are stored on a physically separate USB drive; the application does not use the boot card as a media fallback.
- Aggregate electrical measurement, an internal charging subsystem, a single
  system power control, and automatic low-battery shutdown are not V1 gates
  under the July 18 product-owner decision.
- Version 1 uses a simple box-shaped 3D-printed enclosure.
- The version 1 enclosure should remain reasonably compact and expose all required user-accessible components.
- Weight optimization, ergonomic shaping, integrated lighting, tripod mounting, and weather resistance are deferred to later revisions.
- A failed camera does not cause successful images from that capture to be discarded.
- Version 1 saves and processes the available images when a capture set is incomplete.
- The screen reports incomplete captures with the failed camera number and relevant diagnostic details.
- Wi-Fi hotspot, browser access, and remote network features are deferred until the onboard system is highly polished.
- The available central-computer prototype is a Raspberry Pi 4 Model B with 2 GB RAM.
- A touchscreen and 3D printer are already available.
- Approximately $200 remains for version 1.
- The bench-top, USB-powered end-to-end milestone from four camera nodes through Raspberry Pi GIF generation and touchscreen review is complete.
- Removable USB media fault qualification is complete and the external battery
  arrangement is accepted. The product owner is building the compact enclosure
  asynchronously; software work proceeds with Milestone 5.
- Progress is milestone-based without a fixed version 1 deadline.

## Provisional Ideas

- Raspberry Pi 4 Model B as the central computer
- Wi-Fi as an alternate transport and possible scaling option
- A shared application protocol that can operate over USB or Wi-Fi
- Live or near-live camera previews before capture
- A much-later device-hosted Wi-Fi hotspot for media access and possible remote control
- Image cleanup and enhancement performed locally on the central computer
- View alignment and appearance matching
- AI-generated intermediate frames
- NeRF or 3D Gaussian Splatting processing
- A dedicated hardware power controller or supervisor for a later revision if
  coordinated shutdown and final load cutoff are reopened

## Major Work Remaining

The ordered implementation plan is maintained in `ROADMAP.md`. Active enclosure
work and exit gates are in `MILESTONE_4_PLAN.md`; `MILESTONE_3_PLAN.md` records
the retired power-measurement plan, and `MILESTONE_2_PLAN.md` plus
`MILESTONE_1_PLAN.md` are completed qualification records.

- Choose total enclosure width and define the curve/convergence geometry for a future 12+ camera array.
- Implement the planned GIF frame duration, playback direction, loop behavior,
  output, and export controls through the Milestone 6 settings plan.
- Optimize or explicitly accept the measured 3.250-second median four-node review path against the soft two-second target; run a focused Wi-Fi spike only if USB exposes a concrete blocker.
- Measure the installed display's outer bezel/depth; the Pi-reported 150x100 mm area is not an enclosure dimension.
- Retain the installed final V1 hub/cabling and include it in enclosure-layout measurements.
- Design future image alignment, cleanup, and enhancement after the validated raw-image GIF path.
- Design the fast-follow live-preview architecture.
- Add live preview after version 1 works end to end.
- Implement and physically qualify the version 2 synchronized settings
  protocol, persistence, manifest evidence, calibration boundary, and native
  800x480 UI defined in `MILESTONE_6_SETTINGS_AND_CONTROL_UI_PLAN.md`.
- Design the compact enclosure, camera mounts, controls, ports, and cooling.
- Lay out the integrated version 1 hardware before fixing enclosure dimensions.
- Provide strain-relieved routes for the external pack's separate Raspberry Pi
  and powered-hub supply leads without enclosing the pack.
- Produce a simple 3D-printable box enclosure with the required external openings and camera alignment.
- Revisit weight, ergonomics, lighting, tripod mounting, and weather resistance after version 1.
- Establish objective reliability, image-quality, runtime, and size targets.
- After the onboard experience is polished, optionally implement hotspot-based media browsing, download, and remote features.

## Draft Definition of Done

The project is complete when a user can pick up the enclosed camera rig and its selected external battery pack, power it on, confirm readiness on its screen, press its physical shutter once, reliably capture all four views, receive a processed bullet-time GIF, review it, and remove or download the finished media without opening the enclosure or manually handling the four camera-node cards.

This definition is a draft and should be refined during the project interview.
