TylerMiddendorf/bullet-time-cam/docs/MILESTONE_1_PLAN.md

# Milestone 1 Plan - Bench-Top End-to-End Capture

Status: complete July 18, 2026. The required behavior and reliability gates
passed; the measured four-node review latency remains above the soft two-second
target and is retained as an optimization item.

## Outcome

Prove the complete version 1 data path on the bench:

`shared shutter -> four ESP32S3 nodes -> Raspberry Pi -> preserved JPEGs -> GIF -> touchscreen`

Battery integration, removable-media hardware qualification, and enclosure work are intentionally outside this milestone. By product-owner direction on July 17, the Pi application no longer stores new capture sets on the Raspberry Pi boot filesystem: it requires writable removable USB storage. Full removable-media validation remains Milestone 2 work.

## Working Technical Direction

- Use the Raspberry Pi 4B 2 GB already on hand.
- Build the Pi application in Python unless the touchscreen or measured performance exposes a reason not to.
- Use USB as the first live-transfer transport.
- Keep transport behind an interface so Wi-Fi can be added without rewriting capture grouping, media handling, or the UI.
- Send each JPEG directly from the ESP32S3 camera frame buffer.
- Do not initialize, read, write, or require camera-node microSD storage.
- Do not reserve or drive a camera-node GPIO for a status LED.
- Preserve original JPEG bytes without image normalization.
- Generate a separate display/export GIF from the available camera images.
- Resolve the capture root from a writable USB-backed filesystem for every commit; automatically request a `udisks2` mount when needed and never fall back to the boot microSD.
- Keep the physical button connected directly to the shared ESP32S3 trigger line.
- Drive the same shared active-low trigger from Raspberry Pi BCM GPIO17 through the approved 2N3904 open-collector circuit; idle GPIO17 low and pulse it high for 100 ms.
- Treat USB `CAPTURE_STARTED` as the Pi notification path for either trigger source; do not add a Pi trigger-sense input.
- Have each node report capture start immediately so the Pi can enter its loading state and group events from one press.

These are implementation recommendations for the milestone, not irreversible product decisions.

## Checkpoint 1 - Bench Inventory and Pi Bring-Up

Status: retired as a standalone checkpoint at Milestone 1 close. Its required
Pi, display, touch, camera enumeration, and final-hub behavior was validated by
the later integrated checkpoints. Unmeasured mechanical dimensions and
electrical load moved to enclosure and power work rather than keeping this gate
open.

Cost gate: no purchase

Work:

- Record the touchscreen manufacturer, model, size, native resolution, display interface, touch interface, and power requirements.
- Install or verify Raspberry Pi OS on the protected internal boot card.
- Verify the touchscreen displays the desktop or a full-screen test image.
- Verify touch input if the display provides it, although touch interaction is not required for version 1.
- Connect one XIAO ESP32S3 directly to the Pi and record how it enumerates.
- Determine whether the available powered USB hub carries data or only supplies power.
- Record the current firmware, board-core, PSRAM, and USB-CDC build settings.

Exit gate:

- The Pi boots reliably.
- A full-screen test image appears on the intended display.
- One camera node is visible to the Pi over USB.
- The remaining hardware unknowns are written down.

Evidence recorded June 27 and July 8, 2026 (historical partial record):

- A Windows bench host detected one connected XIAO as `COM6`, an ESP32 USB serial/JTAG device.
- Arduino CLI 1.5.1 with Espressif ESP32 core 3.3.10 compiled and uploaded `button_capture` using `esp32:esp32:XIAO_ESP32S3:PSRAM=opi`.
- The compiled sketch used 424,233 bytes of flash and 33,568 bytes of dynamic memory.
- Upload verification identified an ESP32-S3 with 8 MB embedded PSRAM and verified all written image hashes.
- A bounded 115200-baud serial smoke test observed the 2048x1536 camera-ready, microSD-ready, and shared-trigger-ready messages.
- The repository skill at `.agents/skills/deploy-xiao-esp32s3-sense` repeats the guarded compile, upload, and startup verification workflow.
- The Raspberry Pi 4 was imaged successfully and boots to Raspberry Pi OS with its HDMI display working.
- The intended display is confirmed at 800x480 resolution, with HDMI for video and a micro-USB connection for touch and display-side power. A July 17 live Pi query reports HDMI-A-2 at 800x480, 65.681 Hz, a 150x100 mm physical area, EDID make `Addi-Data GmbH`, model `0x0004`, and serial `0x00000001`. Its USB touch controller is `8888:6666`, runs at 12 Mb/s, and advertises USB 5 V / 100 mA maximum (0.5 W) in its device descriptor. This is the interface's declared maximum, not a measured whole-display/backlight load.
- Touch input on the intended display now works on the Raspberry Pi.
- The product owner's final V1 hub and cabling are installed. A July 17 live Pi query reports a VIA Labs `2109:3431` upstream four-port hub feeding a Terminus `1a40:0101` four-port hub; all four stable ESP32 identities enumerate concurrently through the downstream hub at 12 Mb/s. The touchscreen and removable USB drive also enumerate on the installed chain, and the earlier 40/40 four-node run used this topology.
- On July 10, 2026, the Pi was verified on the bench LAN as `camerapi` at `10.0.0.136` with OpenSSH available. A dedicated ED25519 development key was installed and a fresh key-only login succeeded as user `username`; the verified Pi host-key fingerprint and non-secret operating instructions are in `RASPBERRY_PI_SSH.md`.
- Linux reports the display's generic EDID identity, 150x100 mm physical area, and the USB interface's declared 5 V / 100 mA maximum. The enclosure-facing outer bezel/depth and actual display/backlight current cannot be measured over SSH and still need a manual caliper/load measurement if the enclosure or battery calculation requires them. A direct-to-Pi camera comparison is no longer required because the installed final hub/cabling has demonstrated four concurrent links. Raw inventory interpretation and limitations are recorded in [`evidence/milestone-1/checkpoint-1/pi-display-usb-inventory-2026-07-17.md`](evidence/milestone-1/checkpoint-1/pi-display-usb-inventory-2026-07-17.md).

## Checkpoint 2 - Offline Media and UI Vertical Slice

Status: retired as a standalone checkpoint at Milestone 1 close. Complete and
partial ordered GIF generation plus touchscreen state behavior passed with real
four-node data in Checkpoints 5-7.

Cost gate: no purchase

Use local JPEGs under `photos/` so Pi software can progress before camera transfer changes. Images in that directory are never tracked; run `python -m pi_app.tools.prepare_sample_photos` to reproduce the deterministic complete and Camera-4-missing sample sets.

Work:

- Define a capture-set directory containing:
  - `manifest.json`
  - `camera_01.jpg` through `camera_04.jpg` when available
  - `bullet_time.gif`
- Include capture ID, logical camera IDs, dimensions, byte counts, timing, and errors in the manifest.
- Build the GIF from images ordered by logical camera number.
- Make forward/backward playback configurable; an initial test sequence can be `1,2,3,4,3,2`.
- Keep GIF resolution, frame delay, and looping configurable until they are chosen from touchscreen and performance tests.
- Implement a minimal full-screen state machine:
  - `READY` or the last result
  - `LOADING`
  - `REVIEW`
  - `REVIEW_WITH_ERROR`
- Keep the latest animation visible until the next simulated capture.
- Exercise complete sets `photo_0001` through `photo_0006`.
- Use the missing Camera 4 `photo_0007` as the first partial-capture test.
- Measure JPEG loading, GIF generation, and display time on the Pi.

Exit gate:

- The reproducible local sample photos produce a preserved capture set and animated GIF.
- The touchscreen moves through loading and review states.
- The partial set produces a usable result and identifies Camera 4 as missing.
- Stage timings are recorded.

## Checkpoint 3 - One-Node Direct USB Transfer

Status: retired as a standalone checkpoint at Milestone 1 close. Its protocol,
integrity, stable-identity, reconnect, and timing requirements passed through
Checkpoint 4 and later hardware regressions.

Cost gate: no purchase

Work:

- Keep node capture and USB transfer as separate operations without node-local storage.
- Emit a capture-start event immediately after the debounced trigger is accepted.
- Add a binary-safe protocol with, at minimum:
  - Protocol version
  - Stable hardware UID
  - Local capture sequence number
  - Event or message type
  - JPEG width, height, and byte length
  - JPEG payload
  - CRC32 or equivalent integrity check
  - Explicit success/error response
- Keep human-readable diagnostics inside framed protocol messages so logs cannot corrupt JPEG payloads.
- Hold the camera frame buffer until transfer succeeds or the transfer attempt ends.
- On the Pi, discover the node, receive to a temporary file, verify length and checksum, then atomically rename the JPEG into its capture set.
- Map the hardware UID to logical Camera 1 in Pi configuration rather than compiling different firmware for each board.
- Instrument trigger accepted, frame ready, transfer start/end, validation, and file commit times.

Proposed transfer test:

- 20 consecutive full-resolution transfers
- Zero checksum or truncation failures
- Reconnect the USB cable and confirm the node is rediscovered without editing code

Exit gate:

- One physical button press produces one verified JPEG on the Pi without reading the node microSD card.
- The node is identified consistently after reconnect.
- Measured transfer time is recorded.

## Checkpoint 4 - Complete One-Node Full-System Bench Test

Status: complete July 17, 2026

Cost gate: no purchase; use one node, the available powered data hub, Raspberry Pi, and touchscreen

Purpose:

At the time, this checkpoint built the narrowest real vertical slice before the
broader offline and transport-isolation work: one physical trigger caused one
node to capture, transfer the JPEG directly over USB through the hub, preserve
it on the Pi, perform representative display processing, and show the result on
the touchscreen. Necessary portions of Checkpoints 2 and 3 were absorbed here;
their remaining product behavior was later accepted in Checkpoints 5-7.

End-to-end path:

`physical shutter or Pi GPIO17 pulse -> one ESP32S3 -> frame-buffer JPEG -> USB hub -> Raspberry Pi -> validated original on removable USB storage -> display artifact -> touchscreen`

Work:

- Refactor the node firmware so capture and USB transfer are separate operations; remove all node microSD code, messages, card checks, backup behavior, and deployment requirements.
- Remove the node status LED pin, self-test, timing, messages, and writes so `D0 / GPIO1` is unused.
- Retain the framed Pi-to-node USB capture request only as explicitly selected diagnostic scaffolding; it is not a normal touchscreen/Pi capture path.
- Add Pi BCM GPIO17 output support and move normal touchscreen/Pi-initiated captures to a 100 ms hardware-trigger pulse. Do not send a USB `CAPTURE_REQUEST` for the same action; retain it only as explicitly selected test scaffolding if it remains useful.
- Emit framed, binary-safe messages containing protocol version, hardware UID, local capture sequence, event type, dimensions, byte length, payload checksum, and explicit completion/error status.
- Map the node UID to logical Camera 1 in Pi configuration.
- Implement a minimal Pi coordinator with `READY`, `LOADING`, `REVIEW`, and `REVIEW_WITH_ERROR` states.
- Receive into a temporary file, validate byte length and checksum, then atomically commit the original JPEG into a capture-set directory with `manifest.json`.
- Produce and display a representative processed artifact. For one image, this may be a single-frame/duplicated-frame GIF or the original JPEG, but the processing and display stages must remain separately timed so multi-image GIF cost can later be substituted cleanly.
- Keep the latest result visible until the next trigger and require no Pi desktop interaction during normal capture.
- Record errors without discarding a successfully validated original.

Required instrumentation for every run:

- Node monotonic timestamps: trigger accepted, frame acquisition started, frame ready, transfer started, and transfer completed.
- Pi monotonic timestamps: first capture event received, payload receive started/completed, validation completed, original committed, processing started/completed, display request issued, and first result visibly rendered when measurable.
- Derived durations: trigger-to-frame, transfer, validation, storage commit, processing, display update, and total trigger-to-review.
- Context: capture ID, node UID/logical ID, JPEG dimensions and bytes, checksum result, USB device/path, success/error, retry count, and software/firmware versions.
- Pi resource observations during capture, transfer, and processing: CPU load, memory use, and storage bytes written. Record available USB topology/link information; defer electrical power measurement until suitable instrumentation exists.
- Use monotonic clocks for durations. Because ESP32 and Pi clocks are not synchronized, derive cross-device total time from a Pi-observed capture-start event or record the clock-correlation method and uncertainty.

Validation sequence:

1. Demonstrate one complete trigger-to-screen capture and retain its manifest/log.
2. Run at least 20 consecutive full-resolution captures with zero truncation/checksum failures and no overwritten originals.
3. Disconnect/reconnect the node through the hub and confirm automatic rediscovery without code/config edits or a Pi reboot.
4. Force one interrupted transfer and confirm a partial file is not committed as a valid original and the UI reports the error.
5. Report median, p95, slowest, and failure count for each measured stage and total trigger-to-review.

Exit gate:

- One physical button press repeatedly produces one verified, preserved JPEG on the Pi without reading node microSD and displays the result on the touchscreen.
- One normal touchscreen action produces exactly one 100 ms GPIO17 pulse, no USB `CAPTURE_REQUEST`, and the same `CAPTURE_STARTED` through display workflow.
- The prescribed unpowered circuit checks and both powered trigger-source gates are recorded; unresolved electrical exceptions keep this checkpoint open.
- The node remains logically Camera 1 after reconnect, and interrupted transfers fail safely.
- The manifest/log artifacts contain enough stage timing, size, integrity, resource, and failure data to project likely four-node bottlenecks and guide transport, processing, storage, timeout/retry, hub, and later power-test decisions.
- The results and limitations are recorded before Checkpoint 5 begins.

Decision after evidence:

Evaluate the one-node results against:

- Transfer latency
- Reconnect behavior
- CPU and memory use
- Power and wiring implications
- Expected four-node behavior
- Path toward 12+ nodes

Direction chosen from the one-node evidence:

- Continue with USB for version 1 while validating the physical trigger and four-node path; the measured vertical slice is reliable but still exceeds the soft two-second target.
- Run a focused Wi-Fi spike only if USB exposes a concrete blocker; do not build two complete production transports before the first end-to-end milestone.
- Extrapolation may identify risks, but final four-node concurrency and power behavior still require Checkpoints 5 and 7 measurements.

Evidence recorded July 10-11, 2026 (Checkpoint 4 was active at this point):

- Implemented and Git-deployed a CRC-protected `BTC1` USB protocol with PING/HELLO discovery, stable eFuse UID, capture request/start, JPEG image, transfer completion, ACK/NACK, LOG, and ERROR messages.
- Node `E072A1F9A190` is mapped to logical Camera 1. The Pi checkout at `/home/username/bullet-time-cam` was pulled from `origin/main`; firmware and Pi runtime tests were executed from that Git-tracked source.
- Demonstrated the temporary touchscreen/Pi USB request through the powered hub to a 2048x1536 frame-buffer JPEG, Pi checksum/length/decode validation, atomic original commit, manifest creation, and visible touchscreen review. The physical button was not connected for this test.
- Final resource-instrumented run: 20 consecutive captures, 20 complete manifests, zero checksum failures, zero recorded errors, zero leftover `.part` files.
- JPEG size: 554,270-byte median, 561,018-byte p95, and 561,320-byte maximum.
- Node trigger event to frame ready: 1,373.7 ms median, 1,407.2 ms p95, and 1,407.6 ms maximum. The existing settle/warm-up acquisition is the largest latency stage.
- Node USB transfer: 773.1 ms median, 783.5 ms p95, and 784.3 ms maximum. Pi payload receive: 643.2 ms median and 651.1 ms p95.
- Pi payload-received to atomic original commit: 35.9 ms median, 41.7 ms p95, and 63.8 ms maximum. JPEG decode validation was 0.296 ms median after warm-up.
- Capture event to display callback: 2,493.8 ms median, 2,580.0 ms p95, 2,588.4 ms maximum, and 2,422.4 ms minimum. None of this final run met the soft two-second target; acquisition and USB transfer are the primary optimization targets.
- Pi application CPU time from capture event through payload receipt: 220 ms median and 270 ms p95. Peak process RSS was about 59.9 MB median and 61.5 MB maximum; minimum available system memory remained about 1.48 GB and one-minute system load remained below 0.08.
- Terminating the receiver during a requested transfer left the manifest count unchanged and left no `.part` file. After the node's bounded ACK timeout, a new service rediscovered the same UID and completed a reviewed capture without a Pi reboot or configuration edit.
- Concrete evidence artifacts are under `docs/evidence/milestone-1/checkpoint-4/`, including the final 20-run summary, a successful review screenshot, recovery screenshot, representative manifest, and screenshots of defects found and fixed during integration.
- Two physical hub disconnect/reconnect cycles were completed. Kernel enumeration advanced from device 7 to 8 to 9 with the same serial number and `/dev/ttyACM0`; the same service process rediscovered logical Camera 1 without configuration edits or a Pi reboot.
- A later live disconnect visibly produced `No camera node found`, then returned to `Camera 1 connected` after reconnect. Its tapped capture completed before cable removal, so it demonstrates missing-node error presentation and recovery rather than a mid-payload interruption.
- On July 11, a test-only one-shot command deliberately changed one byte of the next live USB IMAGE payload while retaining the original CRC. The Pi independently detected `JPEG metadata checksum mismatch`, sent a targeted NACK, kept the touchscreen UI alive with a visible error, and committed neither a manifest/JPEG nor a `.part` file. Counts remained 44 manifests, 44 Camera 1 originals, and zero partials. The immediately following normal request succeeded as capture 45 with zero partials, and the normal UI service was restored active. Evidence: `docs/evidence/milestone-1/checkpoint-4/checkpoint4-live-nack.txt`, `checkpoint4-live-nack.png`, and `checkpoint4-live-nack-recovered.png`.
- At the end of the July 10-11 run, node simplification and both hardware-trigger sources were still required. Those later passed functional validation on July 17 as recorded below. The deliberately corrupted transfer requirement is satisfied.
- Electrical power was not measured; suitable instrumentation is still required. The later four-node observers validate concurrent protocol integrity, but not aggregate power or the product's four-image atomic grouping/display workflow.

Evidence recorded July 16, 2026:

- Built commit `f9729ea` for `esp32:esp32:XIAO_ESP32S3:PSRAM=opi`, then wrote and verified the same firmware image set on all four Pi-attached nodes. All four cameras reached camera-ready and trigger-ready after flashing, but all four reported `microSD unavailable: card mount failed`; therefore deployment is not fully startup-verified and Checkpoint 4 remains open. The Pi receiver service was restored active and all four stable USB identities remained present. See `docs/evidence/milestone-1/checkpoint-4/four-node-flash-2026-07-16.md` for hashes, node identities, and exact limitations.

The July 16 result above is historical pre-revision evidence. Its card gate was valid for that firmware but is superseded by the July 17 node design.

Evidence recorded July 17, 2026 (Checkpoint 4 was active at the start of this record):

- Pi inspection confirmed Raspberry Pi OS Trixie, kernel `6.18.34+rpt-rpi-v8`, Python 3.13.5, `/dev/gpiochip0`, application-user membership in `gpio`, and installed Raspberry Pi package `python3-lgpio` 0.2.2. Direct `lgpio` was selected as the smallest installed maintained backend.
- Implemented GPIO17 ownership behind an injectable abstraction. It claims BCM 17 LOW, pulses HIGH for the configured 100 ms, returns LOW in pulse-error cleanup, and writes LOW again before release/shutdown. Normal capture sends no USB `CAPTURE_REQUEST`; the USB request requires explicit `--diagnostic-usb-trigger` selection.
- `python -m unittest discover -s pi_app/tests -v` passed 13/13 tests, including initialization, one pulse, repeated pulses, exception cleanup, and mutually exclusive hardware/diagnostic selection.
- Compiled firmware 0.2.0 for `esp32:esp32:XIAO_ESP32S3:PSRAM=opi`: 371,077 bytes flash and 33,368 bytes dynamic memory. Application image SHA-256: `275f9a9c5e18c7383cf1f4b1b4d55280c7070fac40ff1089fcc6f5f20d3f9ab0`.
- Flashed the same non-erase image set with esptool 5.3.1 to `E072A1F99CF8`, `E072A1F99CC0`, `E072A1F9A190`, and `E072A1F9B3E4`; every image write passed hash verification and every board reported 8 MB PSRAM.
- Bounded serial reads on all four nodes passed camera-ready (2048x1536 JPEG quality 8), BTC1 v1 protocol/matching eFuse UID, and shared-trigger-ready gates. No card marker was required or emitted.
- Detailed commands and hashes are in `docs/evidence/milestone-1/checkpoint-4/milestone1-trigger-refactor-2026-07-17.md`.
- Product-owner approval was received to push through `0144180`; `origin/main` and the Pi checkout matched that revision. The Pi reran 13 tests successfully, the pinned installer completed with backup `20260717T194902Z`, and the persistent verifier later passed all 30 checks with the service active.
- Service startup claimed GPIO17 output LOW and did not create a capture. One physical press and one normal touchscreen/GPIO17 pulse each produced exactly one Camera 1 `CAPTURE_STARTED -> validated JPEG -> atomic commit -> display` workflow, with event-to-display times of 2,073.317 ms and 2,065.389 ms and zero errors.
- Separate four-port observers proved one physical press and one real 100 ms GPIO17 pulse each produced exactly one start, one CRC/length/SOI/EOI-valid JPEG, and one completion on all four stable UIDs, with zero duplicates and zero errors.
- A 10-cycle repeated GPIO17 observer, with a measured 150 ms post-completion rearm interval for the unchanged 40 ms release debounce, passed 40/40 starts, valid images, and completions with zero duplicates/errors. Pulse-to-all-completions was 2,455.029 ms median and 2,496.740 ms p95/maximum; start spread was 3.837 ms median and 4.930 ms p95/maximum.
- Raw evidence: `docs/evidence/milestone-1/checkpoint-4/four-node-physical-trigger-2026-07-17.txt`, `four-node-pi-trigger-2026-07-17.txt`, and `four-node-repeated-gpio-2026-07-17.txt`. Full commands, sizes, CRCs, identities, and limitations are in `docs/evidence/milestone-1/checkpoint-4/milestone1-trigger-refactor-2026-07-17.md`.
- The product owner initially connected the circuit while powered before performing the prescribed unpowered checks. Later on July 17, the product owner completed the full multimeter checklist and reported that all continuity, resistance, button, isolation, and no-direct-short checks passed. Individual meter readings were not retained. Together with the powered trigger gates, this closes Checkpoint 4.
- After the capture/trigger evidence above, the product owner added a USB storage drive and replaced the separate removable-card direction. The Pi application now discovers USB-backed mounts, requests automatic mounting through `udisks2`, writes under `BulletTime/`, records storage details in manifests, and fails closed when USB media is absent. Nineteen application tests pass, including mount parsing, USB selection, preferred-drive behavior, automatic-mount rescan, path confinement, and no-boot-storage fallback. The Pi enumerated the added 231 GB FAT partition as `/dev/sda1`, label `USB DISK`; the exact non-interactive mount succeeded from the camera user-service context at `/media/username/USB DISK`, was writable by user `username`, and had confirmed USB sysfs ancestry. The code and a real media commit have not yet been Git-deployed/demonstrated, so the earlier boot-filesystem capture evidence remains historical rather than proof of the new storage path. See `docs/evidence/milestone-2/usb-storage-bringup-2026-07-17.md`.
- A later hardware regression at pushed revision `b950740` supersedes the undeployed-storage limitation above. All four nodes were reflashed with the reorganized firmware and passed camera, BTC1 identity, and shared-trigger startup gates. Ten GPIO17 cycles produced 40/40 valid four-node transfers with no duplicate or error. The pulled Pi refactor passed 24 tests with one intended environment skip, migrated to `bullet-time-ui.service`, wrote CRC-valid real JPEGs to `/dev/sda1`, rebooted to a new boot ID, passed all 33 boot checks, and completed another real USB capture after reboot before restoring the active service and GPIO17 LOW. See `docs/evidence/milestone-1/checkpoint-4/refactor-hardware-regression-2026-07-17.md`. This remains regression evidence, not Checkpoint 5 grouping acceptance.

## Checkpoint 5 - Four-Node Capture and Grouping

Status: complete July 18, 2026

Cost gate: no hub/cabling purchase. The product owner confirms the currently installed chain is the final V1 hub/cabling, and the Pi enumerates all four nodes through it. Retain it unless later aggregate power or reliability evidence exposes a concrete defect.

Work:

- Register all four hardware UIDs as logical Cameras 1 through 4.
- Listen to all node connections concurrently.
- Create a central capture ID when the first capture-start event for a button press arrives.
- Group the other node events into that capture using a bounded arrival window and local sequence/timing metadata.
- Lock out or safely queue a second capture while the current set is active.
- Receive and validate all available JPEGs.
- Preserve successful images even when one node fails.
- Close a set only when all expected nodes have completed or the defined no-progress timeout is reached.
- Write camera-specific errors into `manifest.json` and surface them to the UI.

Proposed grouping tests:

- 25 consecutive normal four-camera captures
- One forced disconnect for each logical camera
- One corrupted or truncated transfer test
- One node reboot between captures
- No images assigned to the wrong capture set

The executable acceptance contract and live scenario procedure are in [`FOUR_NODE_E2E_TEST_PLAN.md`](FOUR_NODE_E2E_TEST_PLAN.md). The deterministic validator tests cover complete and partial sets, corrupt/truncated artifacts, stable UID mapping through a reboot, leftover partials, and duplicate transactions across sets. The physical-rig test is environment-gated until live capture IDs and a completed scenario ledger exist.

Deterministic core progress recorded July 17, 2026: shuffled four-node starts/results, association and no-progress windows, second-trigger rejection, explicit and timeout partial sets, reboot identity, cross-set transaction isolation, atomic capture-set publication, ordered complete/partial GIF bytes, animated-review state, receiver ACK-after-commit/NACK-on-failure, schema enforcement, and typed fault recovery ledgers are covered by the local suite.

Physical-rig evidence recorded July 18, 2026:

- Stable logical mapping is Camera 1 `E072A1F9B3E4`, Camera 2 `E072A1F9A190`, Camera 3 `E072A1F99CC0`, and Camera 4 `E072A1F99CF8`.
- The qualifying normal run completed 25/25 four-image sets: 100 JPEGs, 25 six-frame `1,2,3,4,3,2` GIFs, zero failed normal cameras, zero leftover `.part` files, and 100 unique node transactions.
- One data-only unavailability scenario for each logical camera formed the correct three-image partial set and named only the selected failed camera.
- A Camera 1 `jpeg_checksum_mismatch` set and a controlled Camera 1 `transfer_truncated` set each omitted the bad original, preserved the other three views, produced a partial GIF, and were followed by a complete recovery without rebooting the Pi.
- Rebooting Camera 4 changed its boot ID from `2302327597` to `2564730693` while preserving UID and logical number.
- The artifact validator passed 35 named capture sets, and the environment-gated live hardware test passed in 37.888 seconds.
- Complete ledger, capture IDs, rerun limitations, and postflight are in [`evidence/milestone-1/checkpoint-5/checkpoint5-four-node-e2e-2026-07-18.md`](evidence/milestone-1/checkpoint-5/checkpoint5-four-node-e2e-2026-07-18.md).

Exit gate:

- Normal presses reliably form four-image capture sets.
- Forced failures form valid partial sets with the correct camera-specific error.
- Reconnection does not change logical camera numbering.

## Checkpoint 6 - Integrated GIF and Touchscreen Flow

Status: complete July 18, 2026

Cost gate: no additional purchase

Work:

- Connect the live capture coordinator to the offline media/UI vertical slice.
- Switch to `LOADING` on the first capture-start event.
- Preserve every successfully transferred original.
- Generate the back-and-forth GIF from cameras in logical order.
- Display the new animation until another capture starts.
- Overlay or accompany partial results with the failed camera number and useful details.
- Keep the loading state active while progress continues beyond two seconds.
- Avoid an automatic recapture of a missed moment; transfer retries may reuse the retained frame buffer when safe.
- Keep the screen free of operating-system content during early boot, show `assets/Logo_800x480.png` throughout graphical/application startup, then hand directly to the full-screen camera UI without exposing Raspberry Pi firmware artwork, the desktop, a console/login prompt, a cursor, or startup diagnostics.

Exit gate:

- A real button press completes the full node-to-screen path without manual file movement.
- Complete and partial captures behave as defined.
- The user never needs to interact with the Pi desktop during normal capture.
- A filmed cold boot shows no operating-system or diagnostic frame; after an accepted blank early phase, only the product logo appears before the camera application.

Boot-presentation evidence recorded July 16-17, 2026 (visual sub-gate satisfied; the integrated live-flow evidence follows):

- The first hardware trial used Raspberry Pi's supported early fullscreen image helper, a custom static Plymouth script theme, a logo compositor background, and an app-owned logo first frame.
- Plymouth 24.004.60 crashed in `libply-splash-core`/`libply` before normal root startup; the display showed its backtrace and the Pi never reached networking or the application.
- Two timestamped pre-change backups were created under `/var/lib/bullet-time-boot-backups/` before the failed reboot.
- The repository follow-up removes the custom Plymouth theme, restores the distro `pix` theme as a fallback, and explicitly disables Plymouth. It retains the supported early fullscreen logo and matched compositor/application frames. SD-card recovery and a new cold-boot demonstration are still required.
- The recovered Pi booted when both splash mechanisms were absent, showing only the temporary recovery console before the app logo. A subsequent trial kept Plymouth disabled but re-enabled Raspberry Pi's early fullscreen logo; the Pi produced black/no-signal output and never reached networking. That early-logo path is therefore also rejected for the current OS/kernel.
- The next fallback disables both initramfs splash paths and the HDMI console, leaving a black pre-graphical display before matched compositor/application logo frames. It prioritizes reliable startup and no visible OS/debug output, but does not satisfy the stronger logo-throughout-boot requirement unless a later compatible early-display mechanism is found.
- After the early-logo package, hook, and payload were removed and initramfs rebuilt, a no-`tty1` boot still remained black and never reached networking. The otherwise identical recovery boot with `console=tty1` repeatedly reached userspace, networking, LightDM, and the camera application. The next trial retains but silences and masks that console instead of removing it.
- The masked/silenced `tty1` recovery boot reached networking, LightDM, and an isolated labwc session containing only the logo background and camera application. Re-running the installer then regenerated an already-clean initramfs; the following boot again remained blank and never reached networking. Setting `auto_initramfs=0` produced a successful direct-kernel cold boot (boot ID `a8e32deb-1d79-4964-831a-abe4d1d63197`): system, networking, LightDM, and camera service were active, the 15 automated boot checks passed, and the process list contained only labwc, the logo background, Xwayland, and the camera app. Physical confirmation of the displayed boot sequence remains required before closing the visual exit gate.
- Physical observation of that successful boot found two remaining console lines: `Completed socket interaction for boot stage local` and `... network`. The boot journal traced both to Raspberry Pi Imager's completed NoCloud/cloud-init provisioning pipeline, which tees stage output directly to `/dev/console`. The next trial disables cloud-init through its marker file and kernel-command-line switch and removes the retired `ds=nocloud` selector; visual verification remains open.
- The cloud-init-suppressed reboot showed no operating-system or diagnostic text and the user described the boot presentation as perfect through the application logo. One compositor pointer remained visible over that logo before Tk's cursor setting took control. The next trial installs a transparent Xcursor theme loaded by labwc before its autostart clients; cursor-only visual verification remains open.
- Final cold boot `3b377b08-599e-434e-bc40-948f24710254` loaded the transparent cursor theme into the logo background, Xwayland, and application processes. All 20 then-current automated boot checks passed, the application was active, and the product owner confirmed the result looked good with no remaining pointer or OS/debug frame. The accepted behavior and replacement-Pi procedure are recorded in `docs/RASPBERRY_PI_BOOT_RUNBOOK.md`.
- The replacement-Pi audit expanded verification to 28 checks and made the installer provision its pinned Python environment and LightDM autologin keys. A real installer rerun created backup `20260717T123705Z`; subsequent cold boot `a067e50f-99de-4080-b2fa-3198eec8e80a` passed all 28 checks, ran only labwc, swaybg, the camera app, and Xwayland, and contained no cloud-init stage messages. Package installation now uses `--no-upgrade` to preserve the selected image's existing desktop/session versions.

Integrated live-flow evidence recorded July 18, 2026:

- Physical shared-shutter capture `20260718T051907Z_50cdc484` and normal touchscreen/GPIO17 capture `20260718T052128Z_0f21e734` each persisted byte-valid four-image originals plus a six-frame GIF without desktop interaction.
- The user photographed the normal animation on the intended display. A controlled Camera 4 failure then proved that Cameras 1-3 remained reviewable in a partial GIF.
- The first partial-screen photograph exposed a presentation defect in which a generic background reconnect error replaced the camera-specific result. Commit `710eadd` preserved the review message/color, and the user confirmed the corrected emitted screen. Capture `20260718T053522Z_f906ef32` independently validates successful Cameras 1-3, failed Camera 4, and trigger source `pi_gpio17`.
- The temporary Camera 4 test lock was removed, Camera 4 passed its bounded firmware 0.2.3 startup smoke on stable UID `E072A1F99CF8`, `bullet-time-ui.service` returned active, and GPIO17 returned output LOW.

## Checkpoint 7 - Performance and Reliability Pass

Status: complete July 18, 2026, with the soft two-second latency target unmet

Cost gate: no purchase

Record these timestamps for each node and capture set:

- Trigger accepted
- Frame ready
- Transfer started
- Transfer completed
- Original committed
- GIF completed
- First frame displayed

Use the measurements to separate:

- Existing 700 ms settle and warm-up cost
- Sensor capture cost
- USB transfer cost
- Storage cost
- GIF-generation cost
- Display-update cost

Validation:

- Run at least 25 additional normal capture cycles.
- Record median, slowest, and failure count.
- Confirm normal results approach the soft two-second target.
- Confirm active progress keeps the loading screen alive.
- Confirm no original is overwritten or assigned to the wrong set.
- Confirm the app recovers after node disconnect/reconnect without a Pi reboot.
- Confirm incomplete captures remain reviewable and preserved.

Exit gate:

- Milestone 1 behavior is repeatable rather than a one-shot demo.
- Remaining latency and reliability limitations are measured and documented.
- The requirements for removable media, battery sizing, and enclosure layout are clearer than estimates.

Evidence recorded July 18, 2026:

- The qualifying 25-cycle run completed 25/25 sets with no normal-capture failure, overwrite, cross-set transaction reuse, or partial artifact.
- First-node event to complete persisted GIF was 3,201.312 ms minimum, 3,250.161 ms median, and 3,288.951 ms maximum.
- Per-camera unavailability, checksum corruption, mid-transfer truncation, immediate recovery, and reboot identity all passed the artifact-level contract.
- The result is repeatable and the dominant acquisition/USB path is measured, but 3.25 seconds does not meet the soft two-second target. Latency optimization remains explicit follow-up work rather than an unverified completion claim.

## Post-Milestone 1 Handoff

1. Execute [`MILESTONE_2_PLAN.md`](MILESTONE_2_PLAN.md): unplug/replug, missing, full, read-only/corrupt, removal-during-write, and deterministic multi-drive selection.
2. Measure aggregate idle, capture, transfer, processing, display, and peak electrical power before selecting battery or regulator hardware.
3. Optimize or explicitly accept the 3.250-second median acquisition/USB review path; the soft two-second target is not yet met.
4. Use the measured bench and power results to select the integrated battery, USB-C charging, monitoring, and safe-shutdown architecture.
5. Begin enclosure layout only after the power components and removable-drive access are fixed.
