TylerMiddendorf/bullet-time-cam/docs/TRIGGER_CIRCUIT.md

# Shared Trigger and Raspberry Pi Control Circuit

Status: approved and bench-validated hardware design. Node simplification and Raspberry Pi GPIO control are deployed; the prescribed unpowered multimeter inspection and separate physical/Pi four-node repeated functional tests pass.

## Design Intent

The version 1 trigger system has two ways to start the same four-camera capture:

1. A normally-open physical shutter button pulls the shared active-low trigger bus to ground.
2. Raspberry Pi BCM GPIO17 drives a 2N3904 NPN transistor, which acts as an open-collector pull-down on that same bus.

The Raspberry Pi does not need a separate GPIO input to observe the shutter. Each camera node reports `CAPTURE_STARTED` over its USB data connection, and the Pi enters its loading state when the first event arrives. A Pi-initiated capture must pulse the hardware trigger only; it must not also send a USB `CAPTURE_REQUEST` for the same user action.

## Assigned Pins

| Device | Pin | Direction | Purpose |
| --- | --- | --- | --- |
| Each XIAO ESP32S3 Sense | `D1 / GPIO2` | Input with internal pull-up | Shared active-low trigger |
| Each XIAO ESP32S3 Sense | `GND` | Ground | Common trigger reference |
| Raspberry Pi 4 | BCM `GPIO17`, physical pin 11 | Output | Drives the transistor base through 4.7 kOhm |
| Raspberry Pi 4 | Physical pin 25 (`GND`; used on the bench), or another `GND` pin | Ground | Common trigger reference |
| Each XIAO `D0 / GPIO1` | Unused | - | No camera-node function |

## Components

- One normally-open momentary shutter button
- One 2N3904 NPN transistor
- One 4.7 kOhm resistor between Pi GPIO17 and the transistor base
- One 100 kOhm resistor between the transistor base and common ground
- Breadboard wiring for the bench prototype

The 2N3904 is used as an open-collector switch:

- Emitter -> common ground
- Base -> junction of the 4.7 kOhm and 100 kOhm resistors
- Collector -> shared trigger bus

The common ground includes the transistor emitter, bottom of the 100 kOhm resistor, Pi ground, all four camera grounds, and the ground side of the physical shutter button. Confirm the transistor manufacturer's actual pin order before applying power; do not rely only on a generic TO-92 drawing.

## Wiring Diagram

```mermaid
flowchart LR
  PI17["Raspberry Pi BCM GPIO17<br/>physical pin 11"] --> R47["4.7 kOhm"]
  R47 --> BASE["2N3904 base"]
  BASE --- R100["100 kOhm"]
  R100 --- GND["Common GND"]

  EMITTER["2N3904 emitter"] --- GND
  COLLECTOR["2N3904 collector"] --- TRIG["Shared active-low TRIGGER bus"]

  BTN["Normally-open shutter button"] --- TRIG
  BTN --- GND

  TRIG --- C1["Camera 1 D1 / GPIO2"]
  TRIG --- C2["Camera 2 D1 / GPIO2"]
  TRIG --- C3["Camera 3 D1 / GPIO2"]
  TRIG --- C4["Camera 4 D1 / GPIO2"]

  GND --- C1G["Camera 1 GND"]
  GND --- C2G["Camera 2 GND"]
  GND --- C3G["Camera 3 GND"]
  GND --- C4G["Camera 4 GND"]
  GND --- PIG["Raspberry Pi GND<br/>physical pin 25 on bench"]
```

Each camera remains connected to the powered USB hub for protocol messages and JPEG transfer. USB is the notification/data path; the shared bus is the simultaneous hardware capture path.

## Required Electrical Behavior

- The camera firmware configures `D1 / GPIO2` as `INPUT_PULLUP`.
- The trigger bus idles high through the four ESP32S3 internal pull-ups.
- Pressing the shutter pulls the trigger bus low.
- Pi GPIO17 idles low. The 100 kOhm base pull-down keeps the transistor off during boot and whenever the GPIO is high-impedance.
- A Pi capture command drives GPIO17 high for 100 ms, then returns it low. The transistor inverts that into a low pulse on the trigger bus.
- The Pi GPIO must never connect directly to the shared trigger bus and must never drive that bus high.
- Do not connect any `5V` or `3V3` rail to the trigger bus.
- Power all camera nodes together, or disconnect an unpowered node from the trigger bus to avoid GPIO backfeed.

## Bench Validation

Before connecting the Pi or cameras, test the unpowered breadboard with a multimeter:

- Emitter, bottom of the 100 kOhm resistor, Pi ground connection, camera ground connections, and button ground must have continuity.
- Collector must have continuity to the shared trigger bus.
- GPIO17 connection must measure approximately 4.7 kOhm to the base junction.
- Base junction must measure approximately 100 kOhm to ground, subject to in-circuit transistor-junction effects.
- Trigger to ground must be open with the button released and near zero ohms with it pressed.
- Trigger to the proposed Pi GPIO connection must not be a direct short.

Then validate in stages:

1. Connect one camera only and confirm one physical press produces one capture.
2. Connect all four cameras and confirm one physical press produces one capture per node.
3. Connect the Pi GPIO circuit after its software initializes GPIO17 low.
4. Confirm a 100 ms Pi pulse produces one capture per node without a duplicate USB request.
5. Confirm physical and Pi-initiated captures both generate USB `CAPTURE_STARTED` events and complete the Pi storage/display path.

## Validation Record

On July 17, 2026, firmware 0.2.0 was flashed to all four nodes and each node passed camera-ready, BTC1 protocol/stable-UID, and trigger-ready startup gates without initializing or accessing a node card. Injected GPIO tests passed initialization LOW, one 100 ms pulse, repeated pulses, and exception/shutdown cleanup LOW.

The product owner initially wired Pi physical pin 25 ground and the trigger circuit to all four powered cameras before performing the prescribed unpowered inspection. The application claimed GPIO17 output LOW without causing a capture. One physical press and one normal touchscreen/GPIO17 action separately completed the Camera 1 `CAPTURE_STARTED -> JPEG validation -> atomic commit -> display` path exactly once. Four-port observers then verified stages 2, 4, and the USB-event/transfer portion of stage 5: each source produced exactly one valid JPEG per UID, with zero duplicates/errors. A 10-cycle Pi run passed 40/40 captures; median pulse-to-all-completions was 2,455.029 ms and maximum start spread was 4.930 ms. GPIO17 returned output LOW and the normal UI service was active after testing.

Later on July 17, the product owner completed the full unpowered multimeter checklist above and reported that every continuity, resistance, button, isolation, and no-direct-short check passed. Individual meter readings were not retained, so the evidence is the product owner's recorded pass rather than a numeric measurement log. Together with the already-recorded powered functional stages, this satisfies the Checkpoint 4 electrical gate. Full four-image grouping, persistence, GIF generation, and touchscreen review subsequently passed Checkpoints 5-7 on July 18. See [`evidence/milestone-1/checkpoint-4/milestone1-trigger-refactor-2026-07-17.md`](evidence/milestone-1/checkpoint-4/milestone1-trigger-refactor-2026-07-17.md), the four named `four-node-*-2026-07-17.txt` raw logs in that checkpoint directory, and [`evidence/milestone-1/checkpoint-5/checkpoint5-four-node-e2e-2026-07-18.md`](evidence/milestone-1/checkpoint-5/checkpoint5-four-node-e2e-2026-07-18.md).
