TylerMiddendorf/bullet-time-cam/designs/ux-mockups/01-v1-ready.png

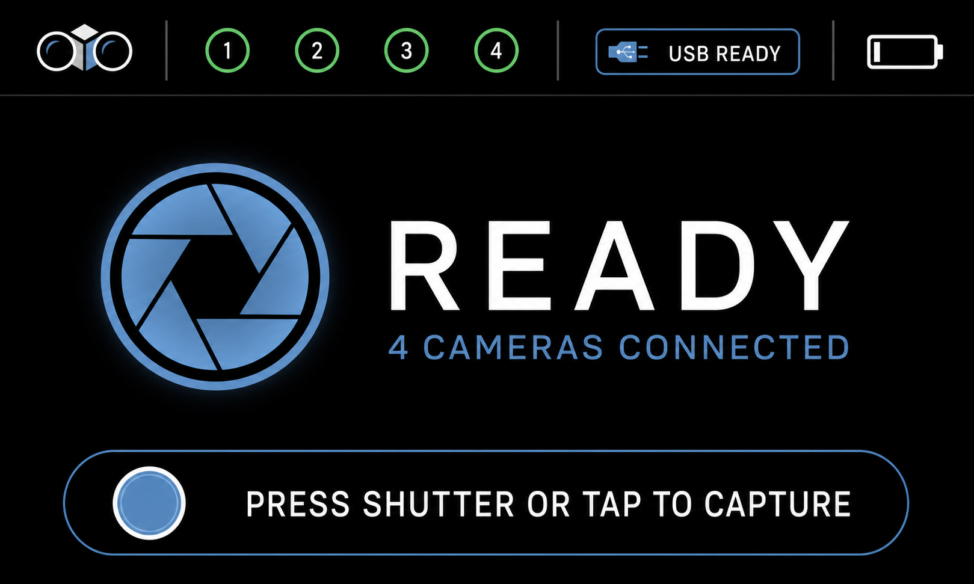
designs/ux-mockups/01-v1-ready.png
