TylerMiddendorf/bullet-time-cam/designs/ux-mockups/02-v1-capture-progress.png

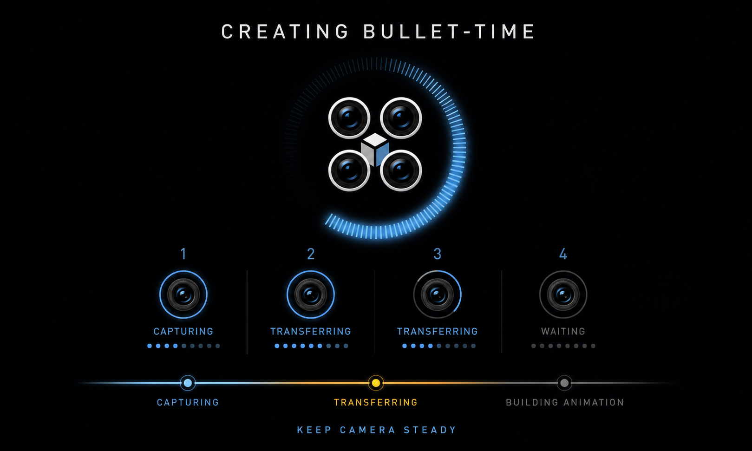
designs/ux-mockups/02-v1-capture-progress.png
