TylerMiddendorf/bullet-time-cam/designs/ux-mockups/03-v1-review-partial.png

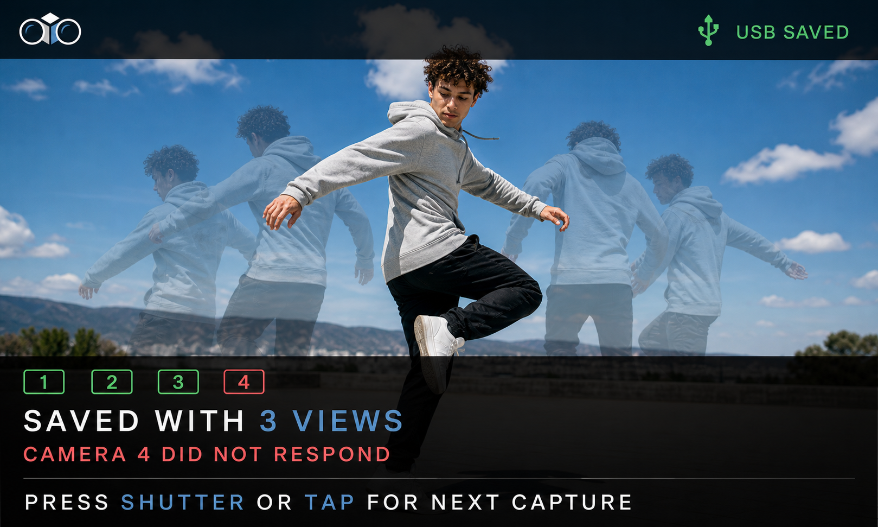
designs/ux-mockups/03-v1-review-partial.png
