TylerMiddendorf/bullet-time-cam/designs/ux-mockups/04-fast-follow-live-preview.png

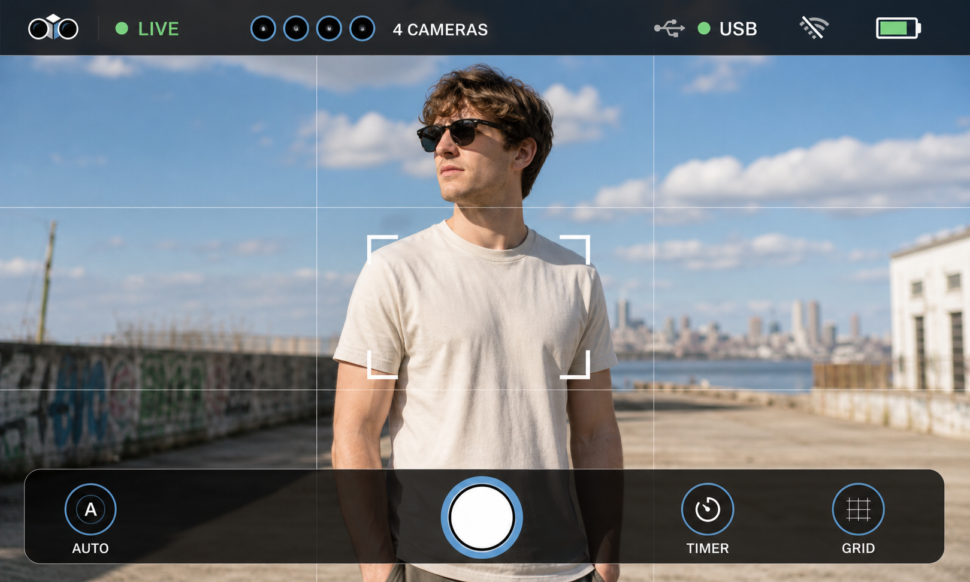
designs/ux-mockups/04-fast-follow-live-preview.png
