TylerMiddendorf/bullet-time-cam/designs/ux-mockups/05-ideal-future-control-center.png

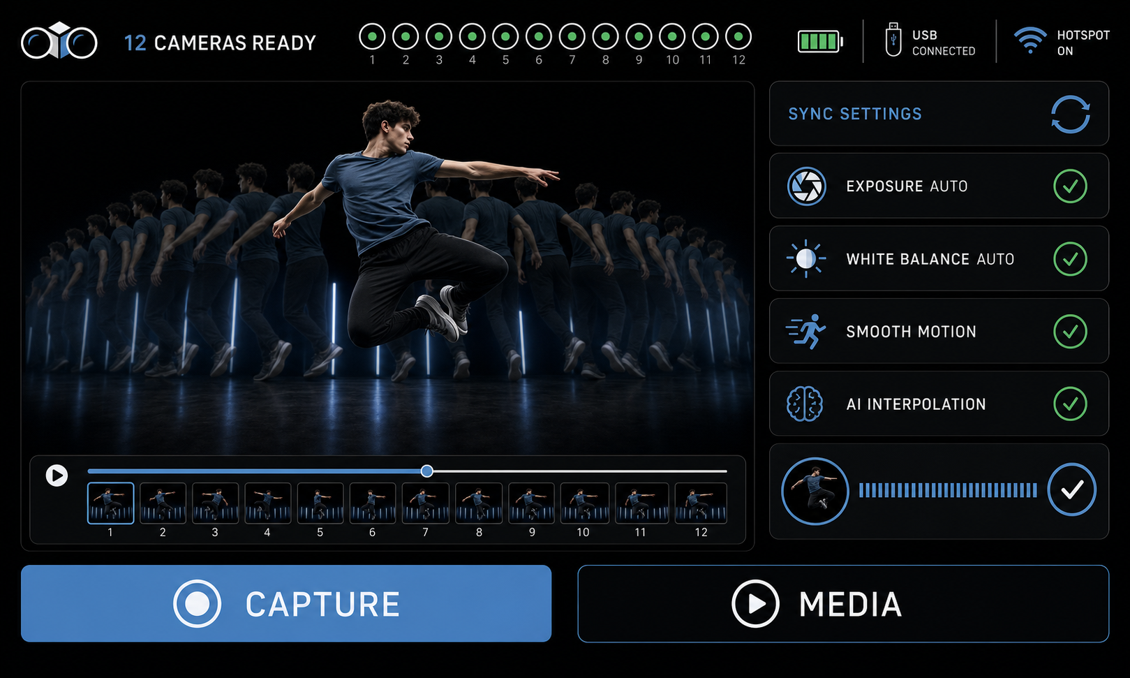
designs/ux-mockups/05-ideal-future-control-center.png
