TylerMiddendorf/bullet-time-cam/designs/ux-mockups/06-library-navigation.png

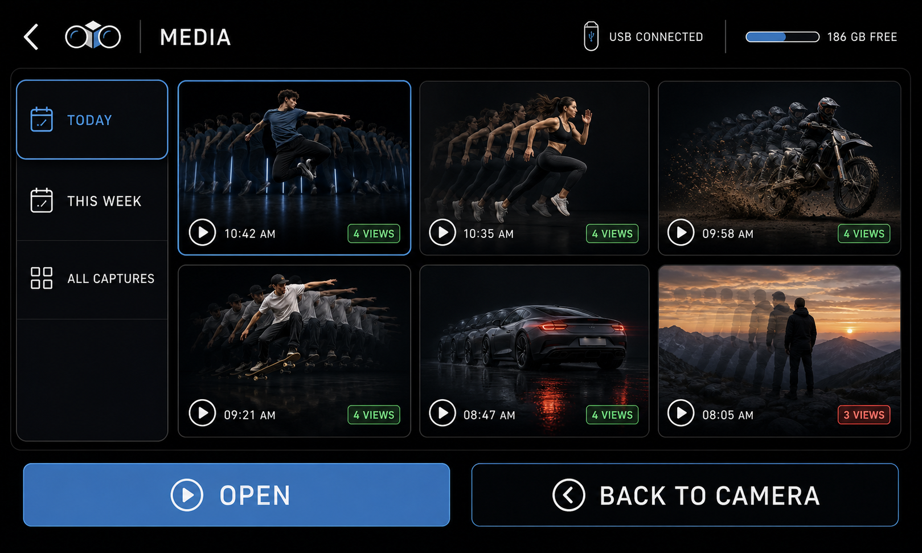
designs/ux-mockups/06-library-navigation.png
