TylerMiddendorf/bullet-time-cam/designs/ux-mockups/07-gif-viewer.png

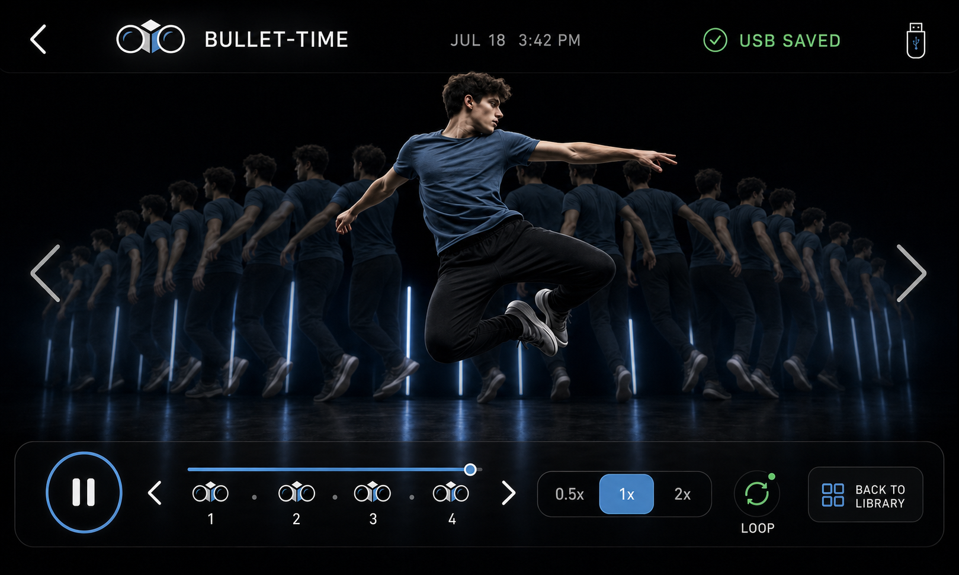
designs/ux-mockups/07-gif-viewer.png
