TylerMiddendorf/bullet-time-cam/docs/evidence/milestone-1/checkpoint-4/checkpoint4-live-interrupt-error.png

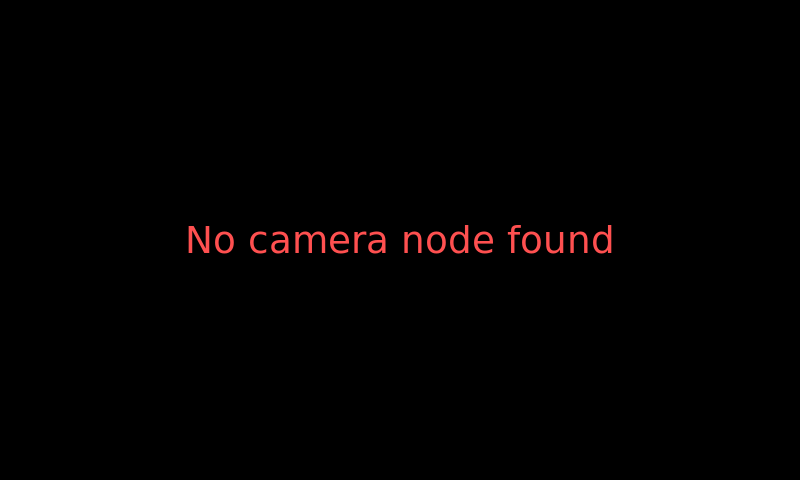
docs/evidence/milestone-1/checkpoint-4/checkpoint4-live-interrupt-error.png
