TylerMiddendorf/bullet-time-cam/docs/evidence/milestone-1/checkpoint-4/checkpoint4-log-overwrite.png

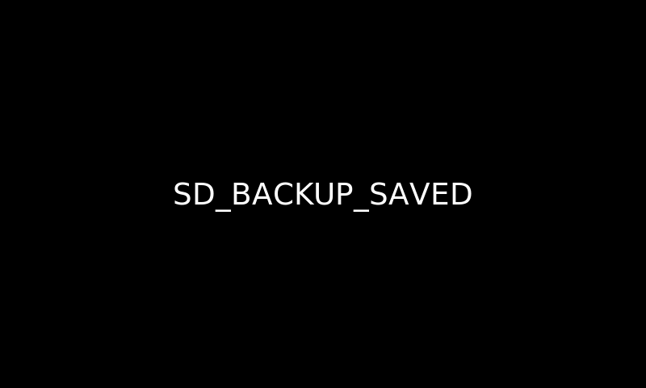
docs/evidence/milestone-1/checkpoint-4/checkpoint4-log-overwrite.png
