TylerMiddendorf/bullet-time-cam/docs/evidence/milestone-1/checkpoint-4/checkpoint4-review-final.png

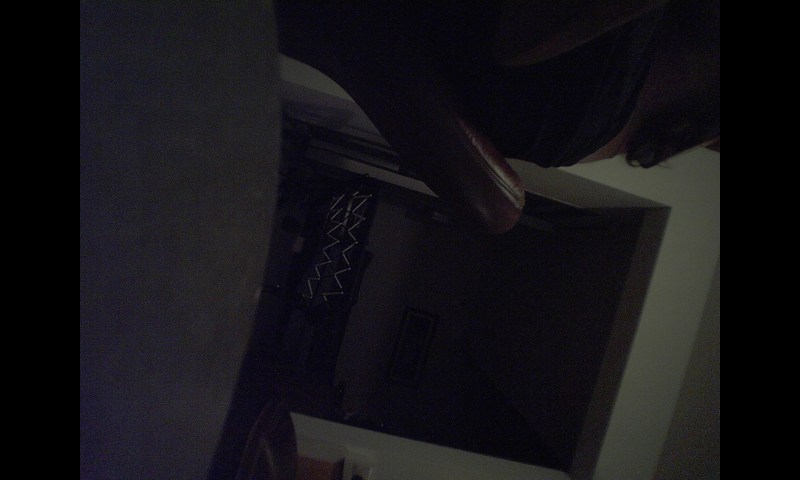
docs/evidence/milestone-1/checkpoint-4/checkpoint4-review-final.png
