TylerMiddendorf/bullet-time-cam/docs/evidence/milestone-2/corrupt-media-click-ui-2026-07-18.png

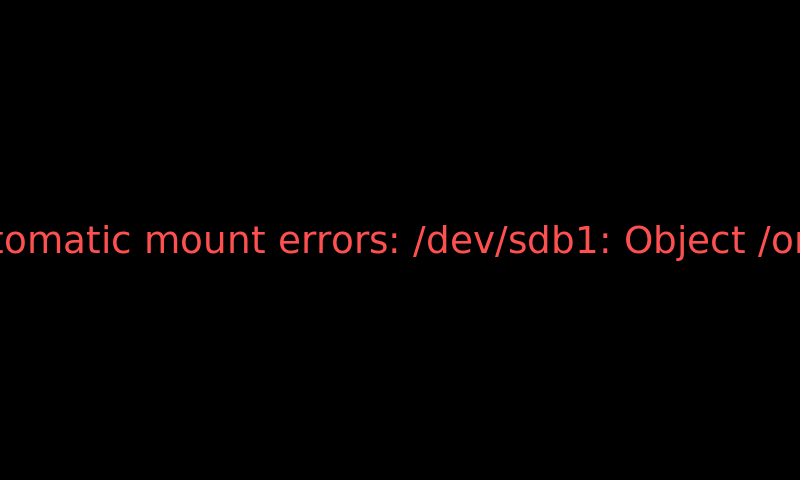
docs/evidence/milestone-2/corrupt-media-click-ui-2026-07-18.png
