TylerMiddendorf/bullet-time-cam/docs/evidence/milestone-2/read-only-media-isolated-ui-2026-07-18.png

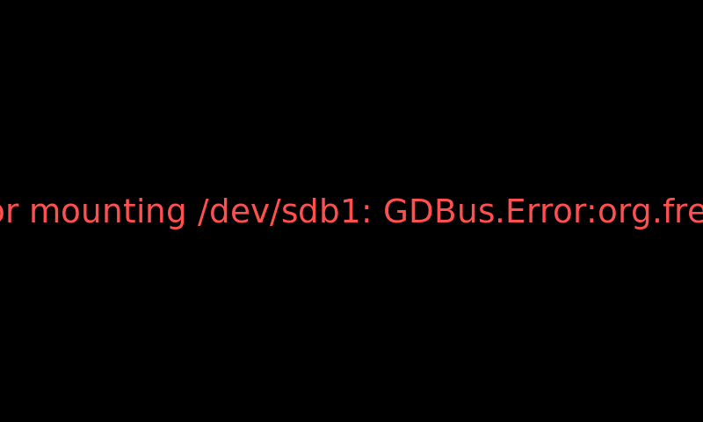
docs/evidence/milestone-2/read-only-media-isolated-ui-2026-07-18.png
