TylerMiddendorf/bullet-time-cam/docs/evidence/milestone-2/removal-during-write-ui-2026-07-18.png

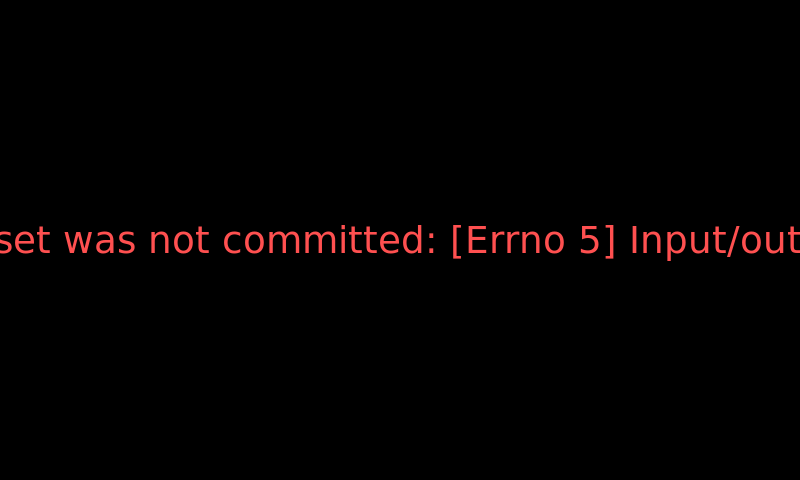
docs/evidence/milestone-2/removal-during-write-ui-2026-07-18.png
