TylerMiddendorf/bullet-time-cam/docs/evidence/milestone-5/genuine-preview-ui-800x480.png

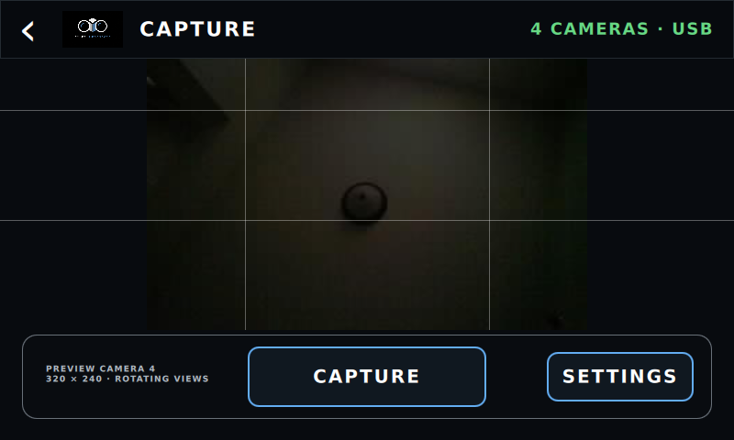
docs/evidence/milestone-5/genuine-preview-ui-800x480.png
