TylerMiddendorf/bullet-time-cam/docs/evidence/milestone-5/preview-active-capture-progress-800x480.png

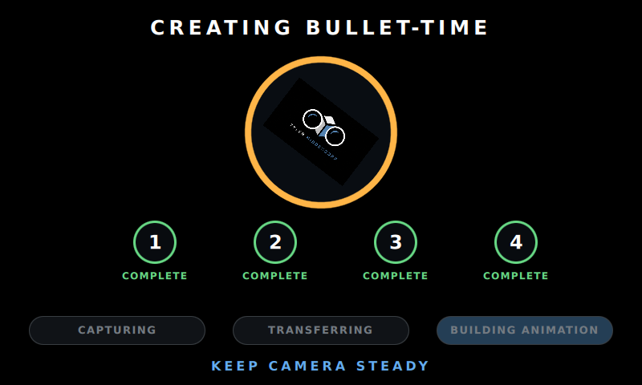
docs/evidence/milestone-5/preview-active-capture-progress-800x480.png
