TylerMiddendorf/bullet-time-cam/docs/evidence/qt-touchscreen/2026-07-18-pi-routes/03-partial-review-800x480.png

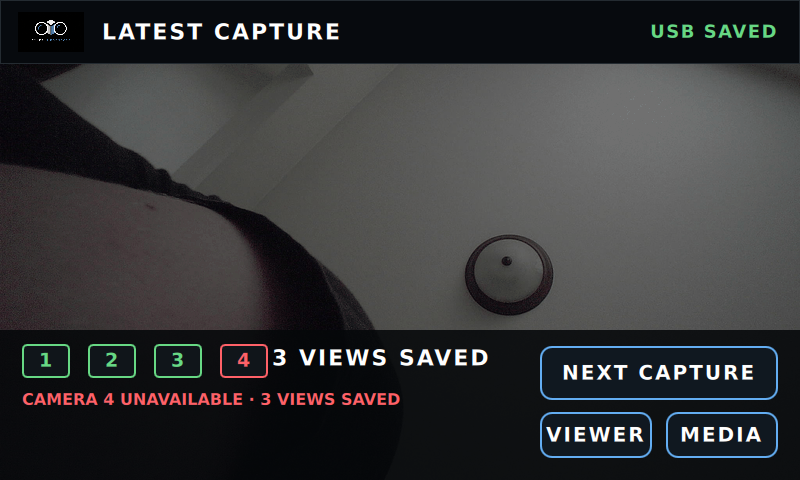
docs/evidence/qt-touchscreen/2026-07-18-pi-routes/03-partial-review-800x480.png
