TylerMiddendorf/bullet-time-cam/docs/evidence/qt-touchscreen/2026-07-18-pi-routes/05-four-camera-control-center-800x480.png

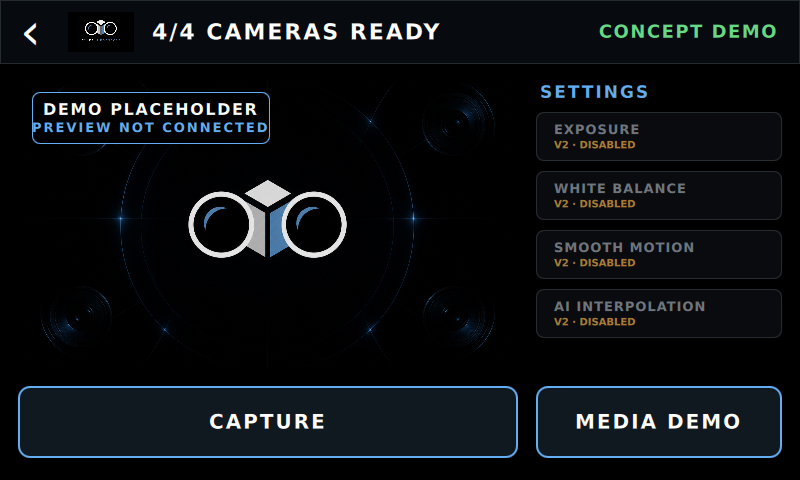
docs/evidence/qt-touchscreen/2026-07-18-pi-routes/05-four-camera-control-center-800x480.png
