TylerMiddendorf/bullet-time-cam/docs/evidence/qt-touchscreen/2026-07-19-navigation-routes/01-ready-800x480.png

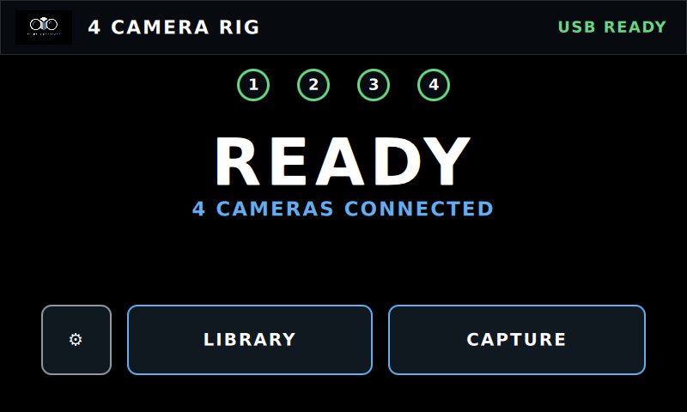
docs/evidence/qt-touchscreen/2026-07-19-navigation-routes/01-ready-800x480.png
