TylerMiddendorf/bullet-time-cam/(commit log)

2026-06-27 Initial four-camera capture prototype
2026-07-11 Document Raspberry Pi SSH access
2026-07-17 Remove splash hook and isolate camera session
2026-07-17 Suppress completed cloud-init boot stages
2026-07-17 Document reproducible Raspberry Pi product boot
2026-07-18 test: cover four-node grouping and media flow
2026-07-18 fix: allow full four-node transfer interval
    [receiver.py]
2026-07-18 fix: tolerate concurrent USB scheduling gaps
    [receiver.py, ui.py]
2026-07-18 fix: track active payload progress
    [coordinator.py, protocol.py, receiver.py]
2026-07-18 fix: retry transient USB write stalls
    [btc_protocol.cpp, firmware_config.h]
2026-07-18 fix: align USB backpressure deadlines
    [button_capture.ino, firmware_config.h]
2026-07-18 fix: stagger four-node USB transfers
    [camera_capture.cpp, firmware_config.h]
2026-07-18 fix: map cameras in physical order
2026-07-18 fix: bound unanswered automatic captures
    [receiver.py]
2026-07-18 fix: back off unavailable camera ports
    [receiver.py, ui.py]
2026-07-18 fix: preserve camera-specific review errors
    [ui.py]
2026-07-18 Fix removable-media UI recovery
    [main.py, storage.py, ui.py]
2026-07-18 Bound camera disconnect diagnostics
2026-07-18 Accept external V1 power arrangement
2026-07-19 docs: complete Qt touchscreen validation track
2026-07-19 Fix Pi route screenshot capture
    [smoke_qt_qml.py]
2026-07-19 Expand Milestone 4 enclosure plan
2026-07-19 Show removable storage capacity in library
2026-07-19 Separate library capacity values
2026-07-19 Record Pi storage capacity verification
2026-07-19 Fix asynchronous library refresh results
    [qt_ui.py]
2026-07-19 Align UX documentation with capture flow
2026-07-19 Add guarded camera USB recovery
2026-07-19 Cover camera recovery in QML harness
2026-07-19 Wait for usable camera serial ports
2026-07-19 Record camera USB recovery evidence
2026-07-19 Refresh USB capacity on home
2026-07-19 Fix stale camera badge on Ready
2026-07-19 Plan synchronized camera settings UI
2026-07-19 Defer enclosure milestone for software work
2026-07-20 Plan isolated four-camera live preview
2026-07-20 Add preemptible camera preview protocol
2026-07-20 Discard stale frames after preview resize
2026-07-20 Keep camera nodes in lightweight preview mode
2026-07-20 Display genuine rotating camera previews
2026-07-20 Report structured QML load errors
    [smoke_qt_qml.py]
2026-07-20 Remove final static camera placeholder dependency
2026-07-20 Add preview-active capture validation timer
2026-07-20 Document validated four-camera live preview
